eng4313/Power-Box/Document/نمایشگر در حالت پیشفرض تعدادی عکس روی نمایشگر نمایش میدهد که هر چند ثانیه عکس ها جابه جا میشود.docx

نمایشگر در حالت پیشفرض تعدادی عکس روی نمایشگر نمایش میدهد که هر چند ثانیه عکس ها جابه جا میشود. همچنین ساعت و تاریخ شمسی نیز در بالای نمایشگر نمایش داده شود.

پایین نمایشگر یک گزینه برای برداشتن و یک گزینه برای گزاشتن گوشی و یک گزینه ورود ادمین نمایش داده میشود که کاربر یکی را میتواند انتخاب کند که پس از انتخاب هر کدام سیستم وارد فرایند مربوط به همان گزینه میشود

فرایند گزاشتن گوشی

اگر کمد خالی وجود نداشته باشد پیغام مربوطه نمایش داده میشود.

اول دو گزینه نمایش داده میشود که نوع گوشی که اندروید یا آیفون است باید توسط کاربر انتخاب شود.

پس از آن یک صفحه کلید روی نمایشگر ظاهر میشود که توسط آن کاربر شماره موبایلی که باید 11 رقمی باشد را وارد میکند و تا زمانی که شماره صحیح نباشد سیستم در همین صفحه میماند و اگر شماره صحیح بود یک پیغام تاییدیه به کاربر نمایش داده میشود که شماره فلان مورد تایید هست یا خیر. اگر خیر انتخاب شد که مجدد به صفحه شماره تلفن برمیگردد جهت ویرایش و اگر کاربر تایید کرد پیغام اثر انگشت خود را وارد نمایید به کاربر نمایش داده میشود. کاربر 60 ثانیه وقت دارد تا اثر انگشت صحیح و خوانا و مورد تایید را وارد نماید و اگر این زمان تمام شد سیستم به مرحله نمایش عکس های پیشفرض بر میگردد و اگر صحیح بود سیستم درخواست ورود اثر انگشت مجدد را به کاربر اعلام میکند جهت انطباق و تایید اثر انگشت و برای این مرحله هم 60 ثانیه وقت به کاربر داده میشود و اگر وقت تمام شد مجدد به مرحله نمایش تصاویر پیشفرض بر میگردد. اگر اثر انگشت ها با هم منطبق نبود پیغام عدم انطباق نمایش داده میشود و اگر منطبق بود در یکی از کمد هایی که خالی است باز میشود و به کاربر 150 ثانیه وقت داده میشود تا گوشی را داخل کمد قرار دهد و درب را ببند و اگر این زمان تمام شد پیغام خطا نمایش داده میشود و ال ای دی داخل کمد چشمک زن میشود و در غیر این صورت چراغ بصورت ثابت روشن میماند.

شماره تلفن وارد شده و اثر انگشت وارد شده در حافظه EEPROM ذخیره میشود و در هر مرحله جهت سهولت کاربر یک پیغام صوتی برای کاربر پخش میشود.

فرایند برداشتن گوشی

بعد از انتخاب گزینه برداشتن گوشی وارد بخش صفحه کلید میشود تا کاربر شماره موبایل را وارد نماید. اگر شماره وارد شده با شماره های ذخیره شده منطبق نبود پیغام مربوطه نمایش داده میشود و به کاربر نهایتا 3 بار فرصت وارد کردن شماره موبایل صحیح داده میشود و اگر این دفعات تمام شد به صفحه نمایش تصاویر پیشفرض بر میگردد و اگر شماره منطبق بود پیغام ورود اثر انگشت نمایش داده میشود و اگر شماره و اثر انگشت با هم منطبق نباشند مثل حالت قبل سه بار به کاربر فرصت داده میشود و در صورت تمام شدن این دفعات پیغام قفل موقت کمد به مدت 30 دقیقه به کاربر نمایش داده میشود و به صفحه اول برمیگردد. اگر انطباق داشت هم درب مربوطه باز میشود و به کاربر 60 ثانیه وقت داده میشود تا گوشی را برداشته و درب را ببندد. اگر درب بسته شد که شماره و اثر انگشت مربوطه از حافظه کمد ها پاک میشود و ال ای دی خاموش میشود و در غیر اینصورت ال ای دی چشمک زن شده و هر 30 ثانیه پیغام درب کمد فلان باز است نمایش داده میشود.

جهت سهولت همه مراحل شامل پیغام صوتی است

ثبت لاگ سیستم

اتفاقاتی حیاتی سیستم باید در حافظه EEPROM ثبت شود که این اتفاقات شامل موارد زیر میباشد.

شماره تلفن کاربر، شماره کمدی که گوشی کاربر درون آن قرار گرفته و ساعت و تاریخ ورود و خروج گوشی. اگر کمد توسط رمز ادمین باز شد باید مشخص شود که توسط ادمین شماره فلان کمد باز شده است.

اگر خطای 30 دقیقه برای کمد رخ داد باید در لاگ ها ثبت شود.

اگر کاربر پس از قرار دادن گوشی درب کمد را نبست باید لاگ ثبت شود.

اگر کاربر پس از برداشتن گوشی درب را نبست لاگ ثبت شود

تعداد لاگ های موجود در سیستم 100 برابر تعداد کمد ها میباشد یعنی اگر تعداد کمد ها 8 تا بود سیستم باید بتواند 800 لاگ آخر را ذخیره نماید و به ادمین ها نشان دهد.

این لاگ ها بصورت صفحه به صفحه و از آخر به اول و در قالب یک جدول باید نمایش داده شود که در هر صفحه 50 لاگ نمایش داده میشود و یه گزینه برای رفتن به صفحه بعد و یک گزینه برای برگشتن به صفحه قبل در این صفحات باید وجود داشته باشد. و این عدد 50 هم باید بصورت دیفاین شده تعریف شود.

ورود ادمین

پس از انتخاب این گزینه وارد بخش صفحه کلید میشود که پس از ورود رمز ادمین وارد منوی مربوط به ادمین میشود و در غیر این صورت پیغام رمز اشتباه است به ادمین نمایش داده میشود. اگر رمز ادمین درست باشد وارد صفحه ای میشود که ادمین با انتخاب شماره هر کمد میتواند درب آن کمد را باز نماید. همچنین ادمین باید بتواند رمز مربوط به خود را تغییر دهد و لاگ های اخر سیستم را مشاهده نماید.

سیستم 20 ادمین مختلف میتواند داشته باشد که یکی از این ها ادمین اصلی است و رمز پیشفرض آن 000000 میباشد و ادمین اصلی همان دسترسی های سایر ادمین ها را دارد و همچنین باید بتواند ادمین را اضافه یا حذف نماید.

همچنین ادمین میتواند 100 لاگ آخر سیستم را مشاهده کند.

نکته مهم اینه که فعلا بورد من میتونه 8 تا کمد مدیریت کنه ولی ممکنه که بخوام با همین بورد یه دستگاه 4 کانال یا 8 کانال مدیریت کنم و طبیعتا باید تعداد این کمد ها دیفاین بشه. همچنین تعداد ادمین ها و رمز پیشفرض و همه این مقادیر باید دیفاین بشن.

یکی از کلید هایی که روی بورد هست هم وظیفه ریست کردن رمز ادمین اصلی به 000000 را دارد که اگر 10 ثانیه فشرده شود این رمز ریست میشود.
