eng4313/Power-Box/PCB/Power_Box_V2/Project Outputs for Power_Box_V2/Power_Box_V2.xlsx

Comment | Description | Designator | Footprint | LibRef | Quantity
Bat Holder 2016-SMD | BATTERY | BAT1 | BAT-HOLDER-SMD-1220 | BATTERY HOLDER | 1
CAP Cer 100nF-50V-X7R-SMD | CAPACITOR | C1A, C1B, C2A, C2B, C2C, C2D, C2E, C2F, C2G, C2H, C3, C5, C6, C8, C9, C10, C11, C13, C14, C15, C18, C19, C20, C21, C22, C23, C24, C25, C26, C27, C28, C29, C30, C31, C34, C36, C39, C41, C45, C46, C50, C51, C52, C53, C54, C55, C56, C57, C59, C61 | C-0805 | CAP-CER | 50
CAP Cer 4.7uF-50V-X7R-SMD | CAPACITOR | C4, C7 | C-0805 | CAP-CER | 2
CAP Cer 10uF-50V-X7R-SMD | CAPACITOR | C12, C35, C38, C58, C60 | C-0805 | CAP-CER | 5
CAP Cer 18pF-50V-X7R-SMD | CAPACITOR | C16, C17 | C-0805 | CAP-CER | 2
CAP Tantal 2.2uF-10V-A-SMD | CAPACITOR | C32, C37 | TAN-A | CAP-TAN | 2
CAP Cer 22uF-50V-X7R-SMD | CAPACITOR | C33 | C-0805 | CAP-CER | 1
CAP Cer 10nF-1KV-X7R-THD | CAPACITOR | C40 | CAP-CER-7x2.5-Ls5 | CAP-CER | 1
CAP Cer 1uF-50V-X7R-SMD | CAPACITOR | C42 | C-0805 | CAP-CER | 1
CAP Elec 1000uF-25V-10x25-THD | CAPACITOR | C43 | CAP-Elec-10x25-5 | CAP-ELEC | 1
CAP Elec 1000uF-10V-5x7mm-THD | CAPACITOR | C44 | cap-Elec-5x7 | CAP-ELEC | 1
CAP Cer 4.7uF-16V-X7R-SMD | CAPACITOR | C47 | C-0805 | CAP-CER | 1
CAP Cer 2.2uF-25V-X7R-SMD | CAPACITOR | C48, C49 | C-0805 | CAP-CER | 2
Connector XH-Straight-THD-2.54mm | CONNECTOR | CN1A, CN1B, CN1C, CN1D, CN1E, CN1F, CN1G, CN1H | XH-5 | CN-5pin | 8
Connector XH-2-Straight-THD-2.54mm | CONNECTOR | CN2 | XH-2 | CN-2pin | 1
Connector FPC Right-0.5mm-50 Pin | CONNECTOR | CN3 | CN-FPC-50-0.5mm-hor | CN-FPC-50pin | 1
Connector XH-Straight-THD-2.54mm | CONNECTOR | CN4 | XH-6 | CN-6pin | 1
Connector FPC Right-1mm-4 Pin | CONNECTOR | CN5 | CN-FPC-4-1mm-hor | CN-FPC-4pin | 1
Diode 1N4148-SMD | DIODE | D1A, D1B, D1C, D1D, D1E, D1F, D1G, D1H, D2 | SOD80 | DIODE | 9
Diode 1N5408-SMD | DIODE | D3 | D-DO214 | DIODE | 1
Diode Schottky SS34-SMD | DIODE | D4 | D-DO214AB | DIODE-SCHOTTKY | 1
Ferrite Bead SMD | INDUCATOR | FB1, FB2, FB3, FB5, FB6, FB7, FB8, FB9 | FB-0805 | FERRITE BEAD | 8
FERRITE BEAD | INDUCATOR | FB4 | FB-0805 | FERRITE BEAD | 1
Header 4x1 Pin -Straight-Male-2.54mm | HEADER | H1 | H-4pin-M-S | HEADER-4pin | 1
Header 3x1 Pin -Straight-Male-2.54mm | HEADER | H2, H3 | H-3pin-M-S | HEADER-3pin | 2
IND 10uH-10x10mm-SMD | INDUCATOR | L1 | IND-SMD-1010 | INDUCATOR | 1
LED GREEN-1206-SMD | LED | LED1, LED3, LED4 | LED-1206-Y | LED | 3
LED RED-1206-SMD | LED | LED2 | LED-1206-R | LED | 1
Mic 2.2mm-THD | MIC | MIC1 | MIC-2.2mm | MIC | 1
TR 2N2222-SMD | TRANSISTOR | Q1A, Q1B, Q1C, Q1D, Q1E, Q1F, Q1G, Q1H | SOT23-213 | 2N2222 | 8
TR S8050-SMD | TRANSISTOR | Q2A, Q2B, Q2C, Q2D, Q2E, Q2F, Q2G, Q2H | SOT23-213 | S8050 | 8
RES 10K-5%-1/8W-SMD | RESISTOR | R1A, R1B, R15, R44, R46, R47, R48, R57, R58, R60, R61 | R-0805 | RES | 11
RES 680R-5%-1/8W-SMD | RESISTOR | R2A, R2B, R2C, R2D, R2E, R2F, R2G, R2H | R-0805 | RES | 8
RES 47K-5%-1/8W-SMD | RESISTOR | R3A, R3B, R3C, R3D, R3E, R3F, R3G, R3H, R6A, R6B, R6C, R6D, R6E, R6F, R6G, R6H | R-0805 | RES | 16
RES 100R-5%-1/8W-SMD | RESISTOR | R4A, R4B, R4C, R4D, R4E, R4F, R4G, R4H | R-0805 | RES | 8
RES 1K-5%-1/8W-SMD | RESISTOR | R5A, R5B, R5C, R5D, R5E, R5F, R5G, R5H, R10, R50 | R-0805 | RES | 10
RES 470R-5%-1/8W-SMD | RESISTOR | R7A, R7B, R7C, R7D, R7E, R7F, R7G, R7H | R-0805 | RES | 8
RES 4.7K-5%-1/8W-SMD | RESISTOR | R8, R9, R11, R12, R14, R56 | R-0805 | RES | 6
RES 82K-5%-1/8W-SMD | RESISTOR | R13 | R-0805 | RES | 1
RES 10R-5%-1/8W-SMD | RESISTOR | R16, R17, R18, R43, R45 | R-0805 | RES | 5
RES 2.2K-5%-1/8W-SMD | RESISTOR | R49, R51, R52 | R-0805 | RES | 3
RES 100K-5%-1/8W-SMD | RESISTOR | R53 | R-0805 | RES | 1
RES 1.2R-5%-1/8W-SMD | RESISTOR | R54, R55 | R-1206 | RES | 2
RES 22R-5%-1/8W-SMD | RESISTOR | R59 | R-0805 | RES | 1
Push Button 3x6mm-2Pin-SMD | SWITCH | S1A, S1B, S2 | SW-SMD-2pin-3x6 | PUSH BUTTON | 3
Screw 3mm | SCREW | SC1, SC2, SC3, SC4 | Screw_M3 | SCREW | 4
Terminal KF301-2Pin-5.08mm-Straight | TERMINAL | TR1 | KF301-2pin | TEMINAL-2pin | 1
IC AT24C04-SMD | IC | U1 | SOIC8 | AT24C04 | 1
IC ISD1730-SMD | IC | U2 | SOIC28-wide | ISD1730 | 1
STM32F429ZGT6 | ARM Cortex-M4 32-bit MCU+FPU, 225 DMIPS, 1024 kB Flash, 256 kB Internal RAM, 114 I/Os, 144-pin LQFP, -40 to 85 degC, Tray | U3 | STM-LQFP144_N | STM32F429ZGT6 | 1
Reg LF33-3.3V-SMD | REGULATOR | U4 | TO252-3pin | LF33 | 1
Reg 7805-5V-THD | REGULATOR | U5 | TO220-HEARSINK-1 | 78Mxx | 1
IC MP3202-SMD | IC | U6 | SOT23-6N | MP3202 | 1
IC W25Qxx-SMD | IC | U7 | SOIC8-W | W25Qxx | 1
IC IS42S16400J-7TLI-SMD | IC | U8 | TSSOP-54 | IS42S16400J-7TLI | 1
IC XPT2046-SMD | IC | U9 | TSSOP-16 | XPT2046 | 1
Crystal 8MHz-SMD | CRYSTAL | Y1 | CRYSTAL-SMD | CRYSTAL | 1
Zener -3.3V-SMD | DIODE | ZD1A, ZD1B, ZD1C, ZD1D, ZD1E, ZD1F, ZD1G, ZD1H | SOD80 | DIODE-ZENER | 8
