eng4313/Power-Box/PCB/Power_Box_V2/Power_Box_V2.pdf

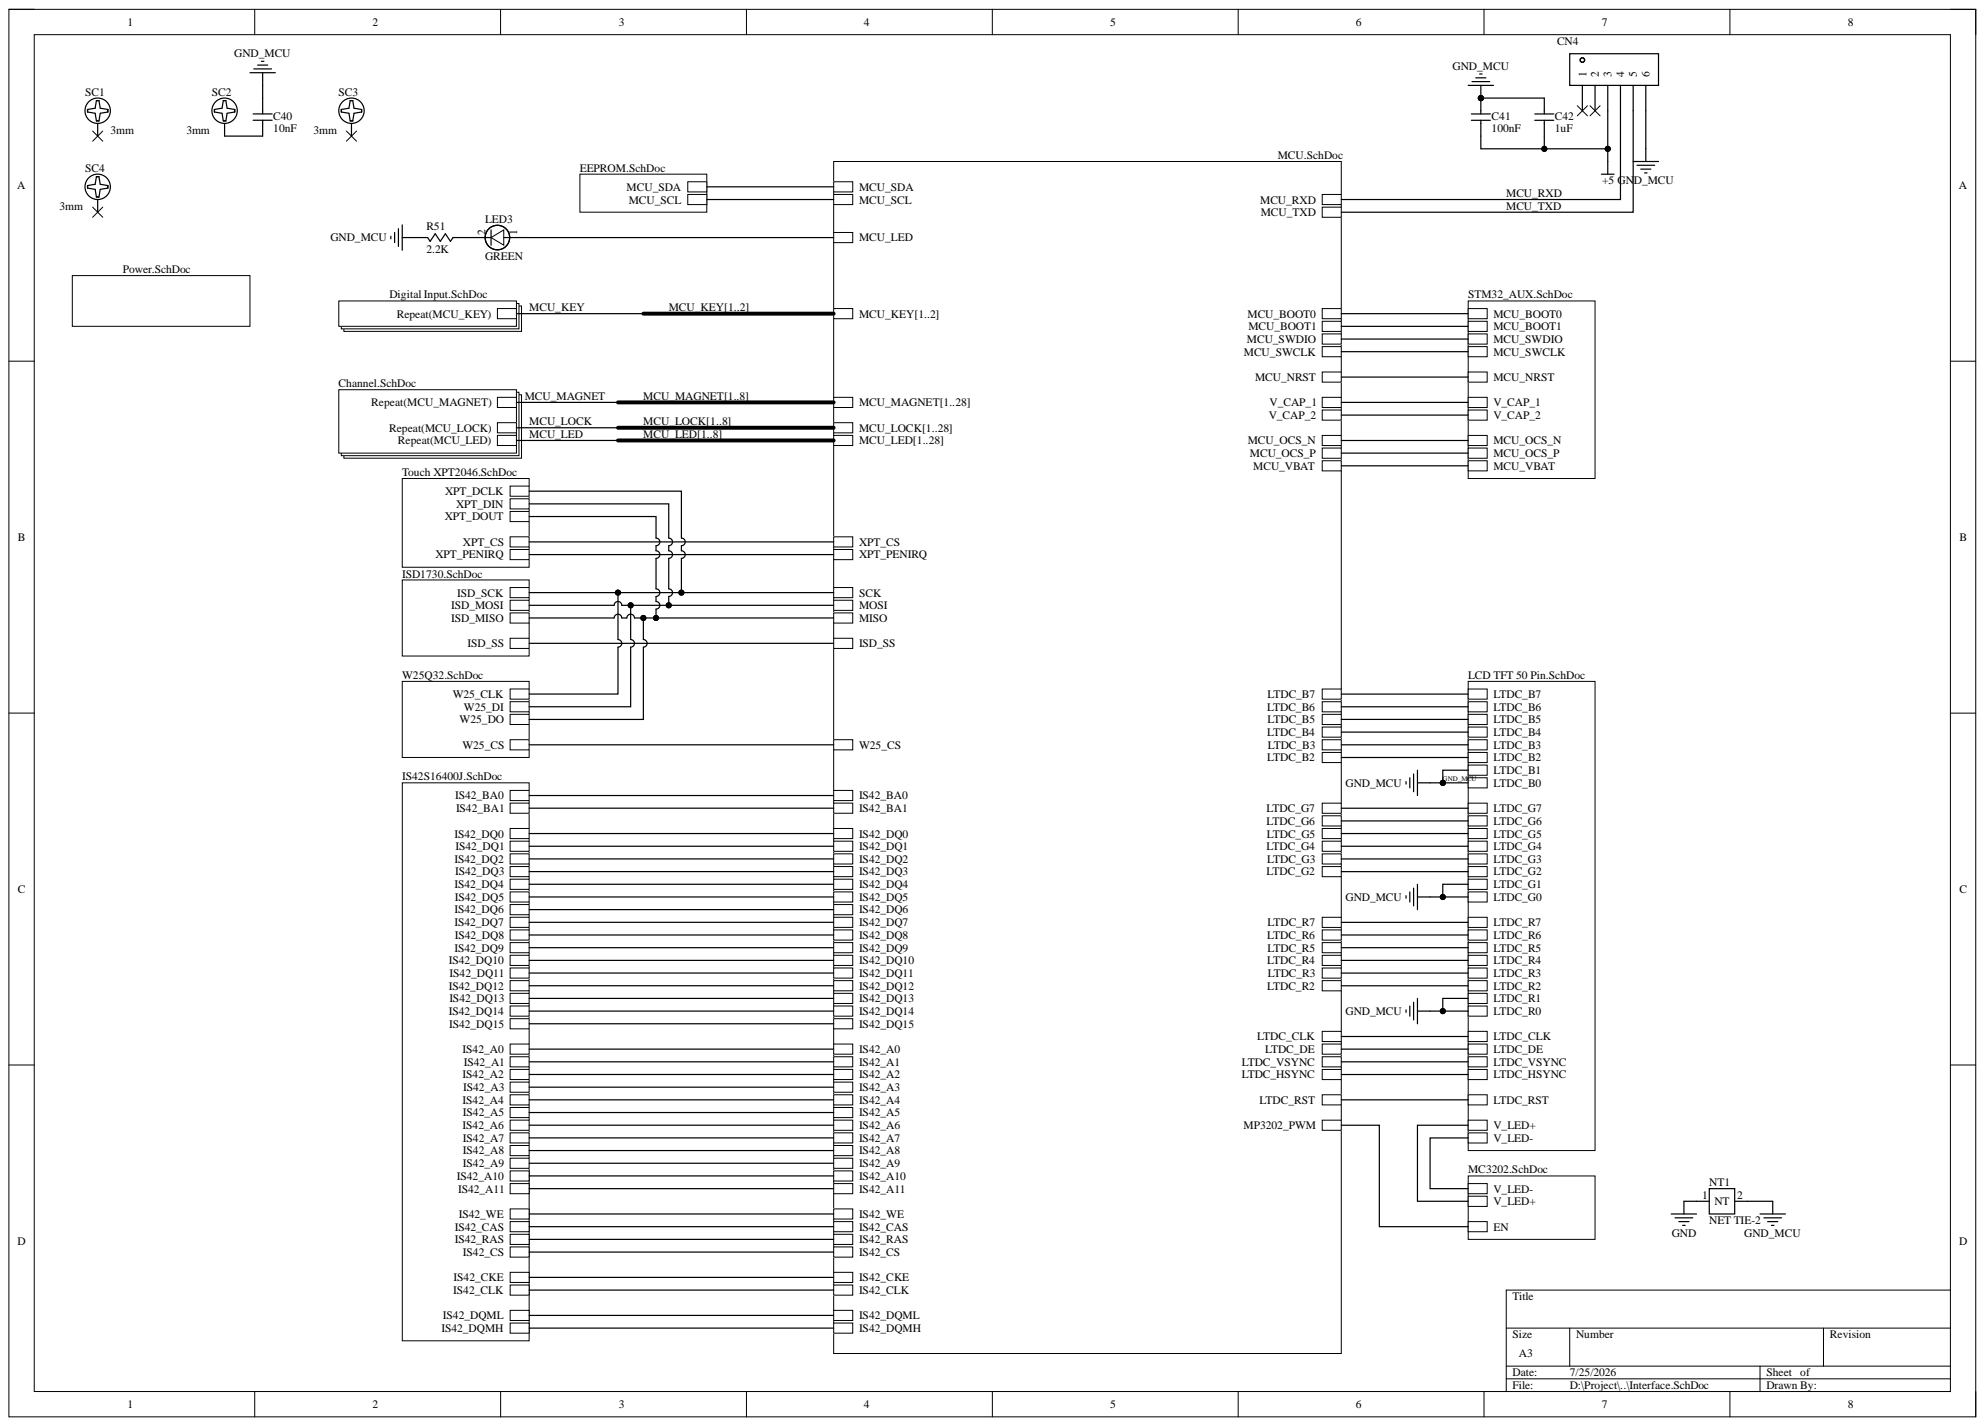
[picture p1: page 1]

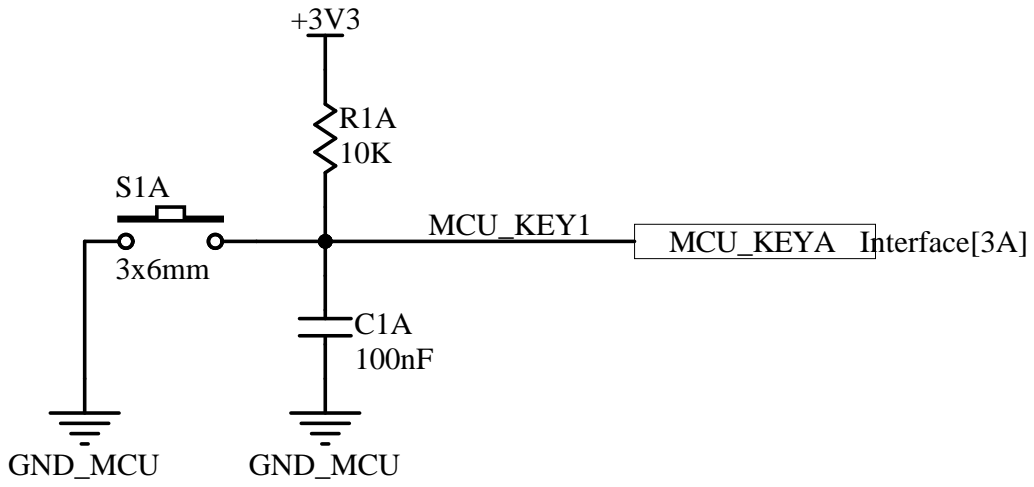
[picture p2: page 2]

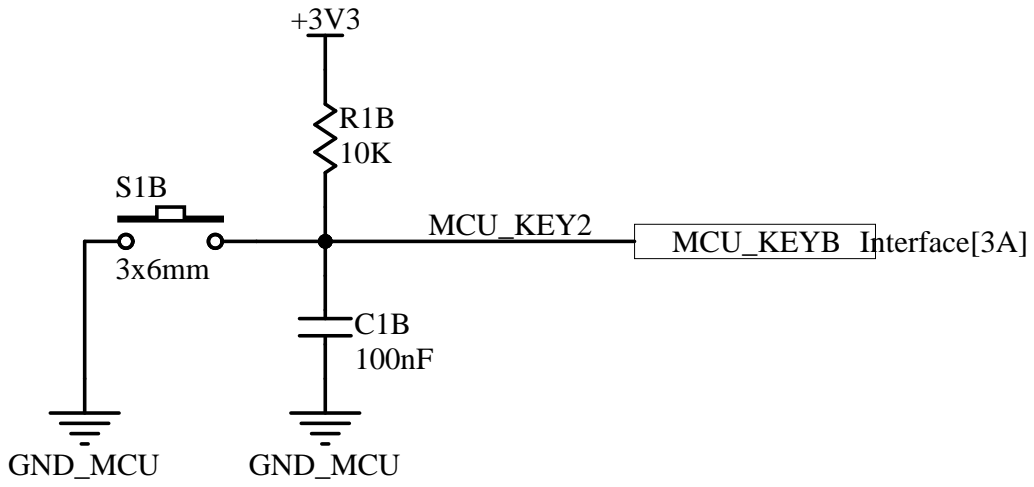
[picture p3: page 3]

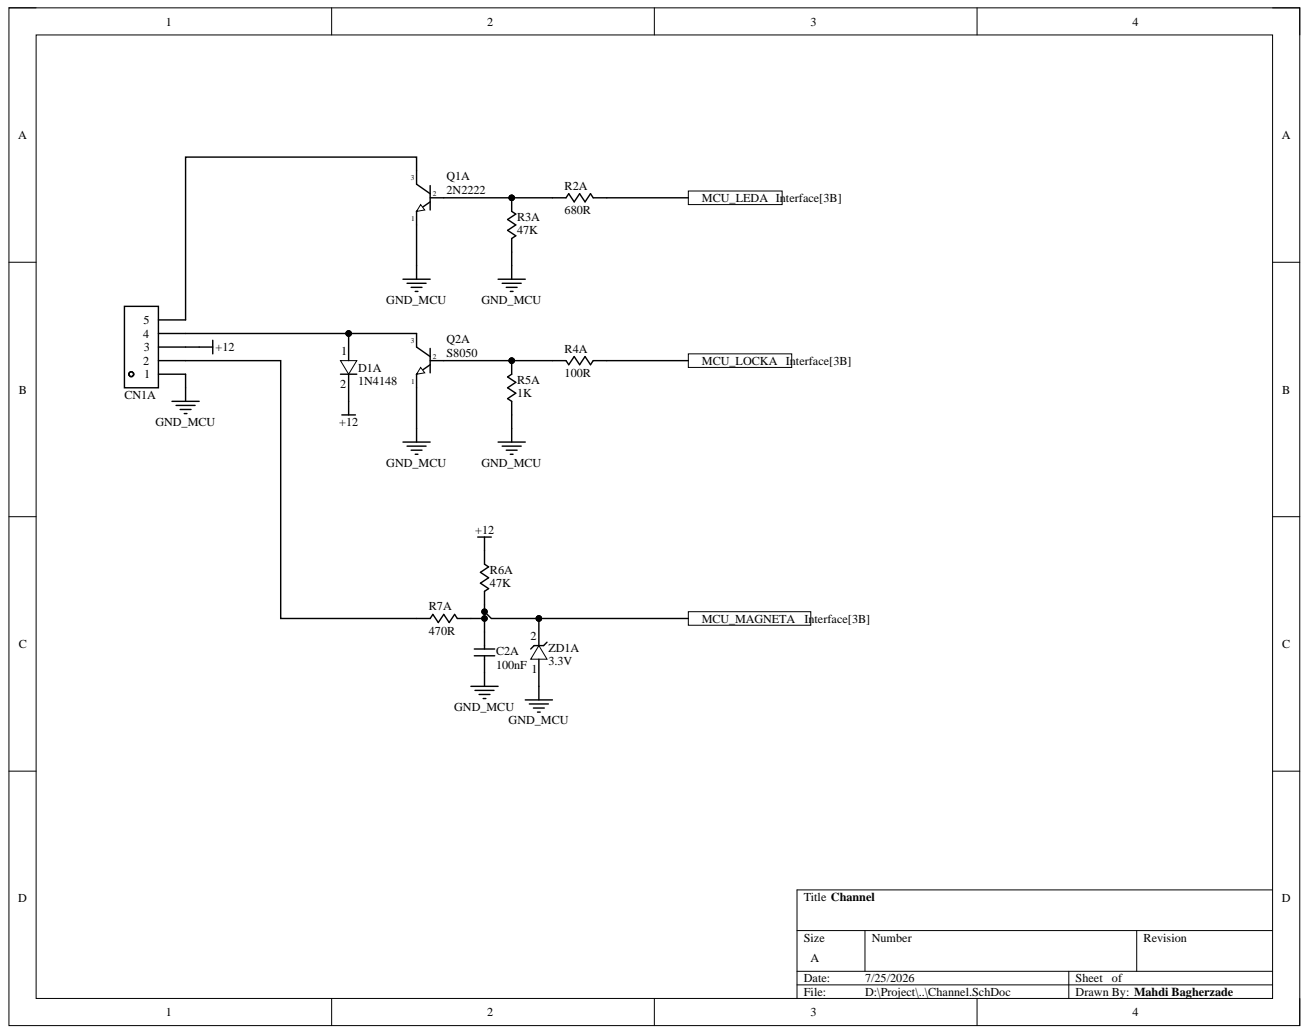
[picture p4: page 4]

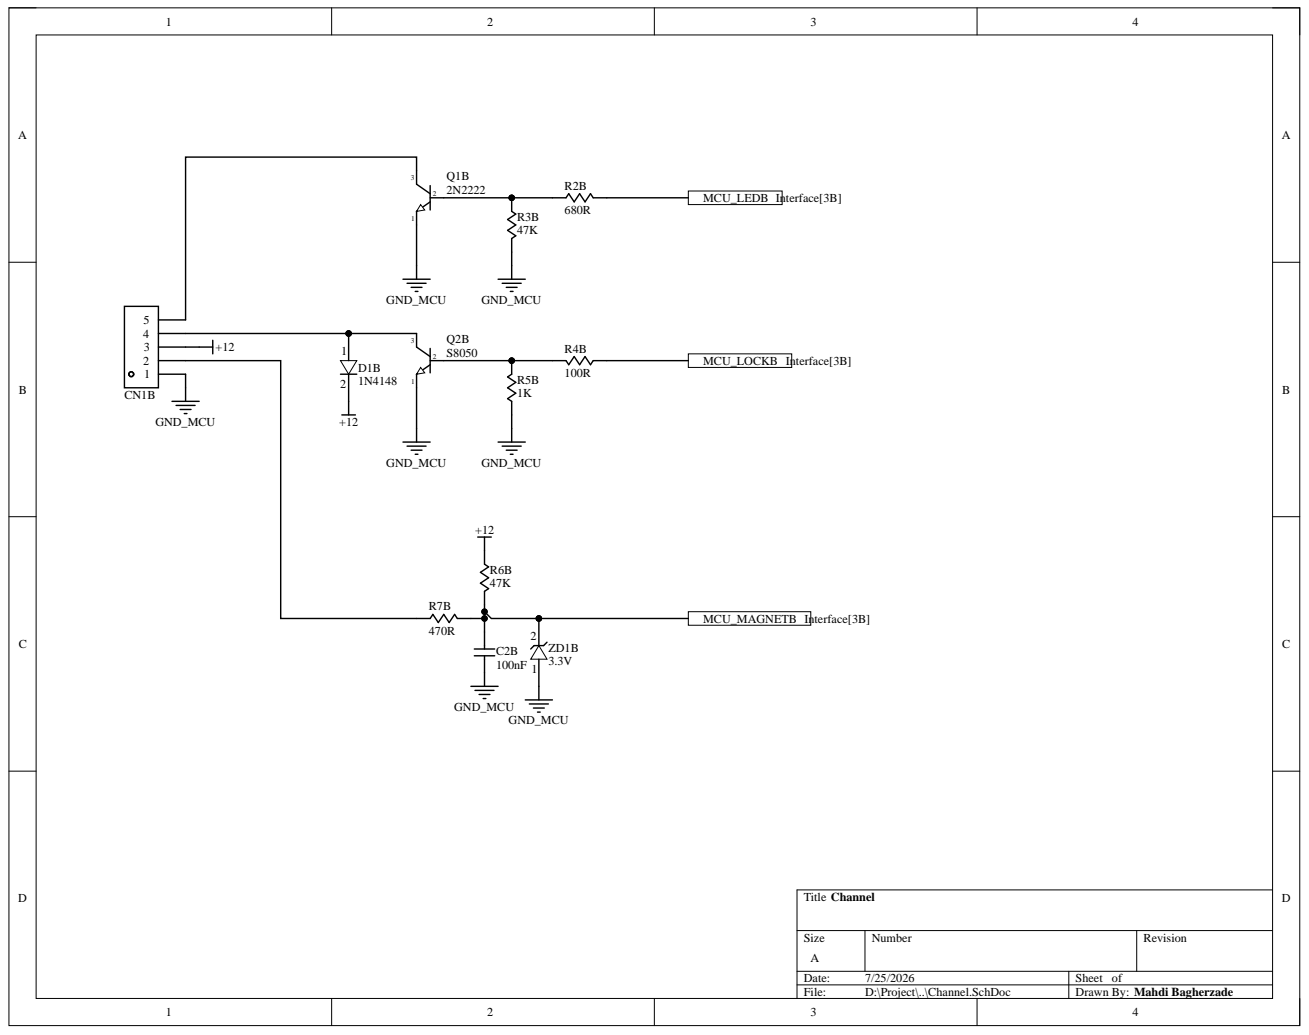
[picture p5: page 5]

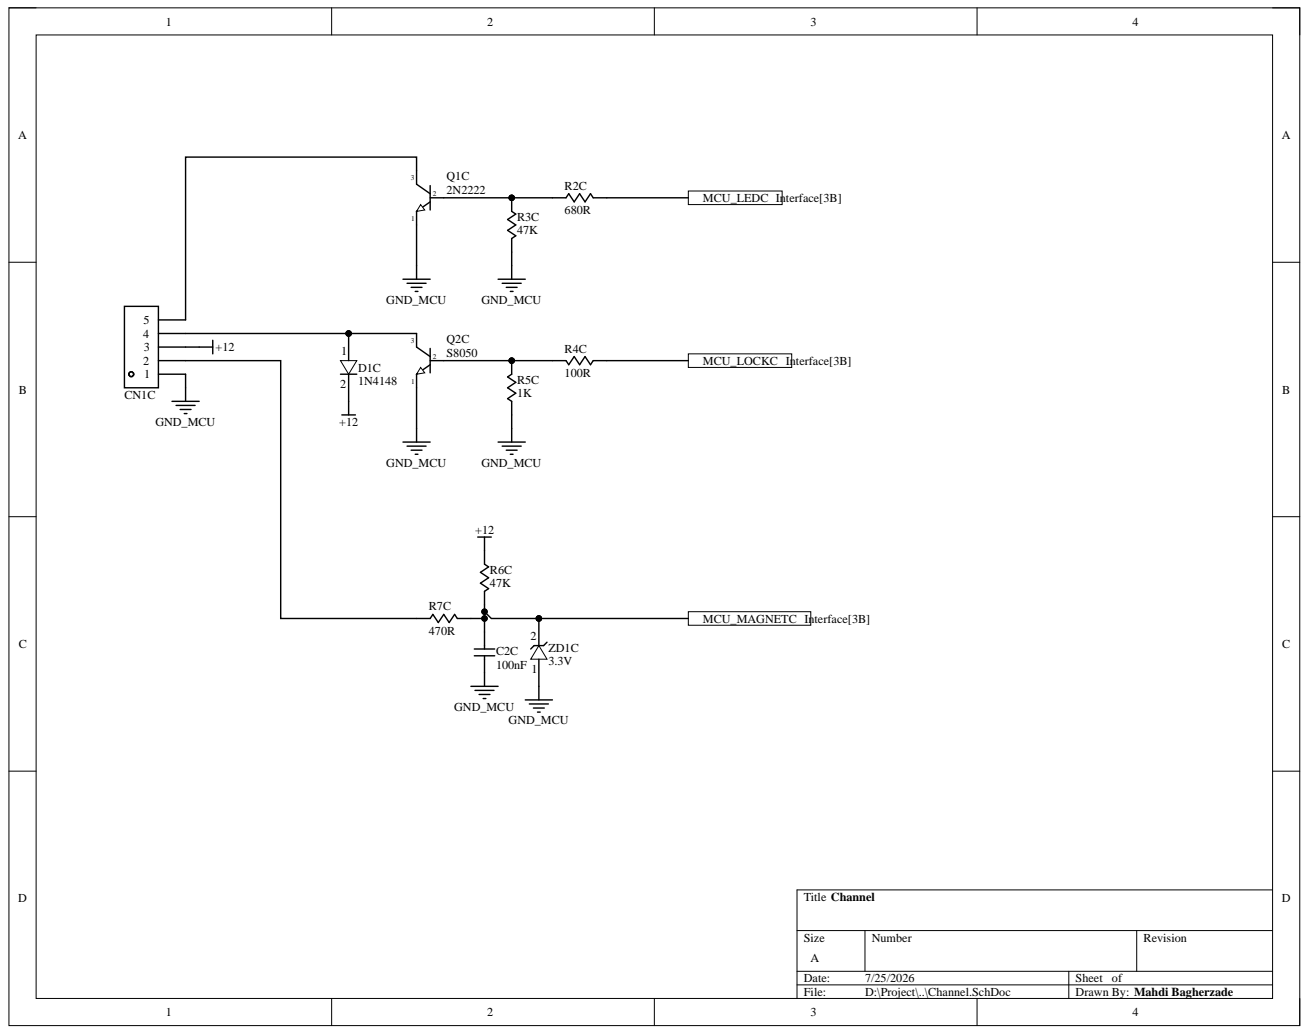
[picture p6: page 6]

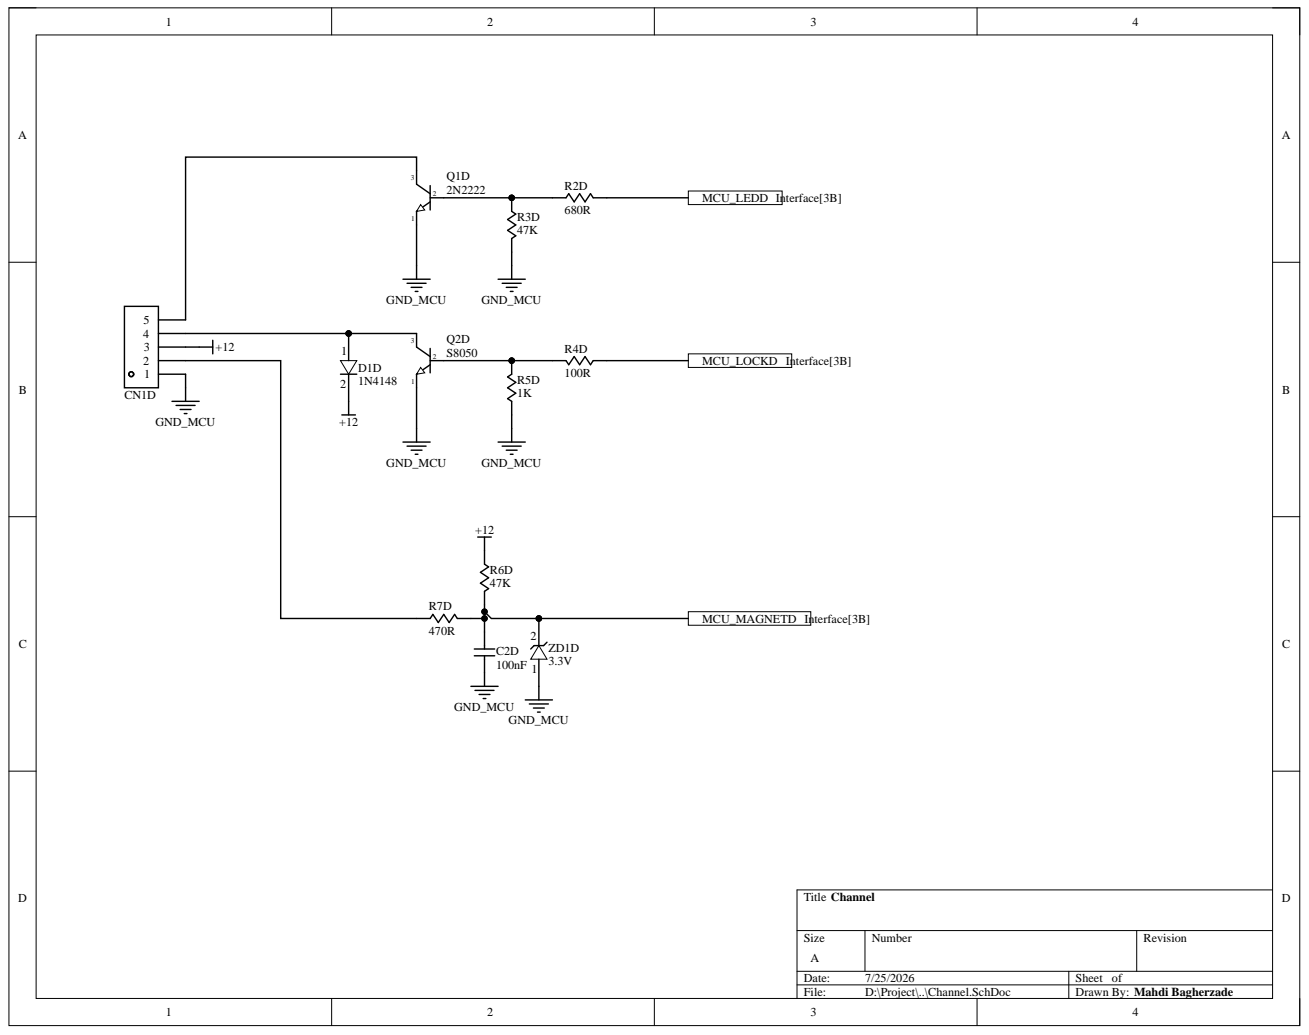
[picture p7: page 7]

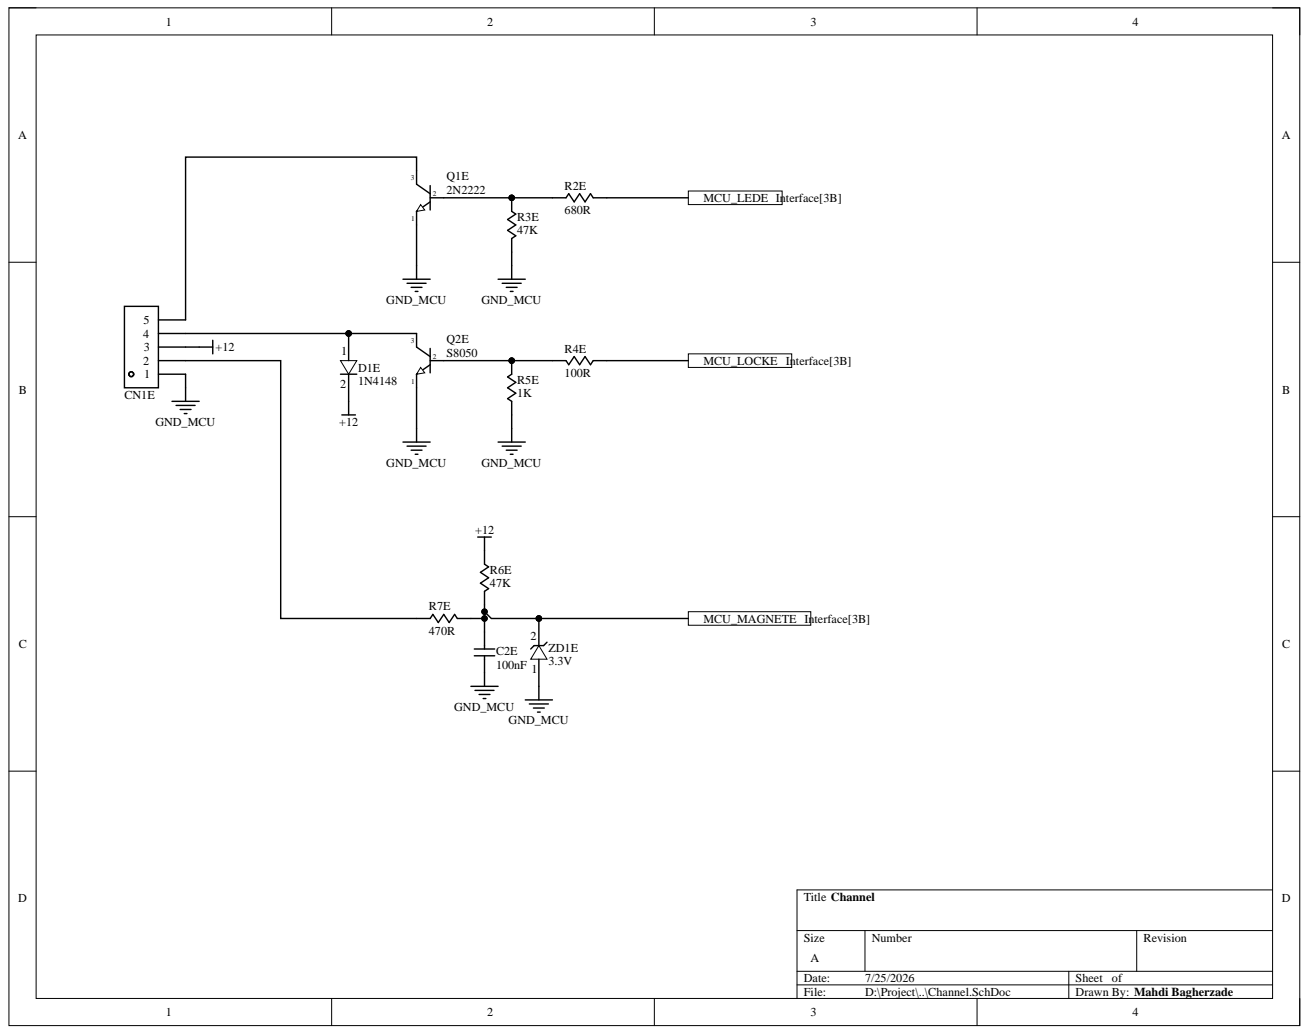
[picture p8: page 8]

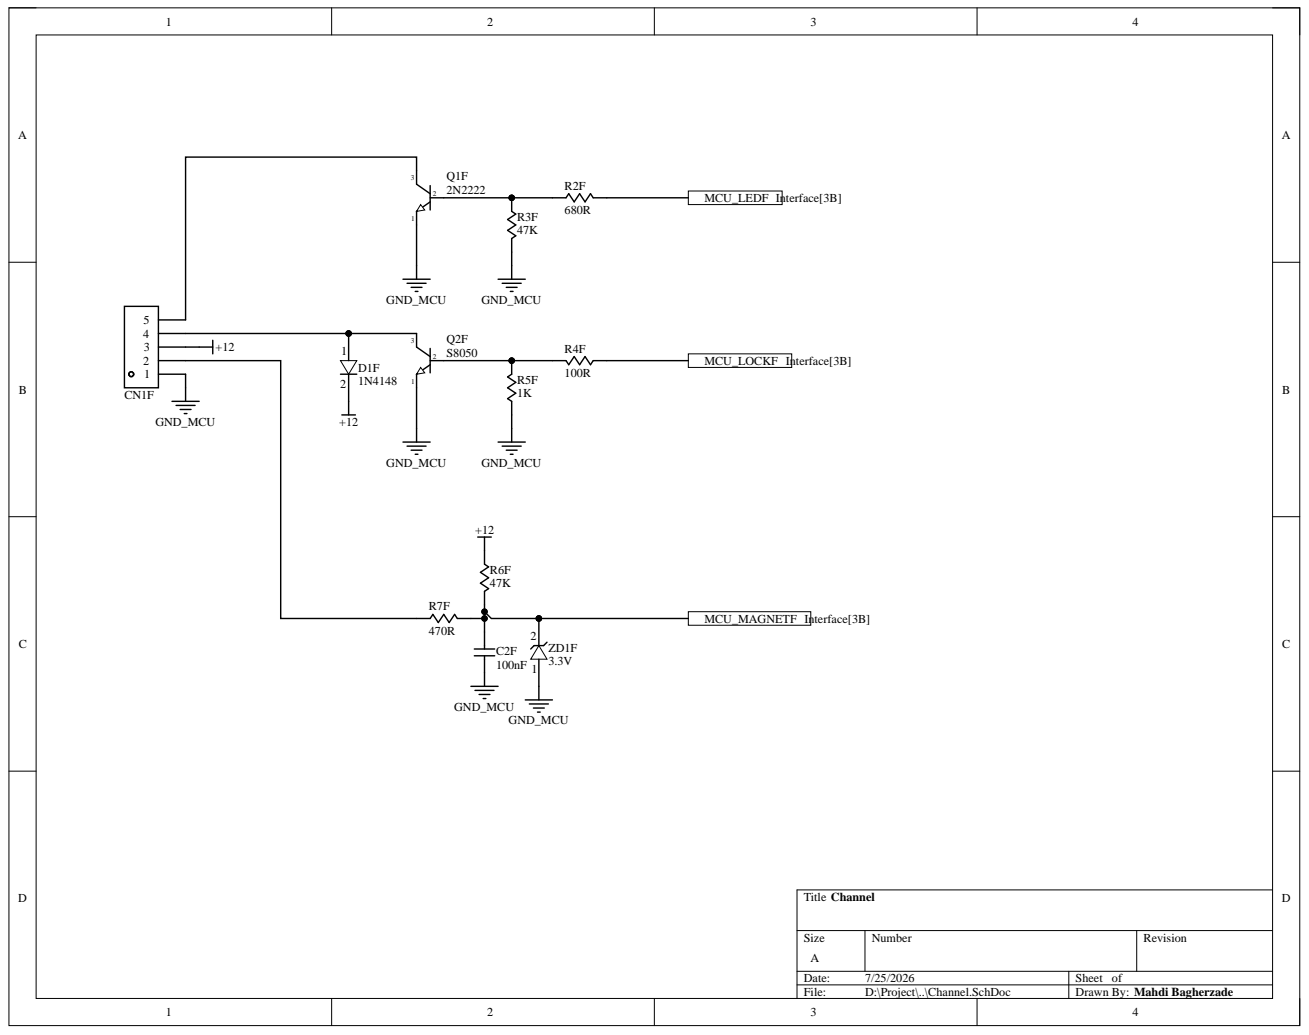
[picture p9: page 9]

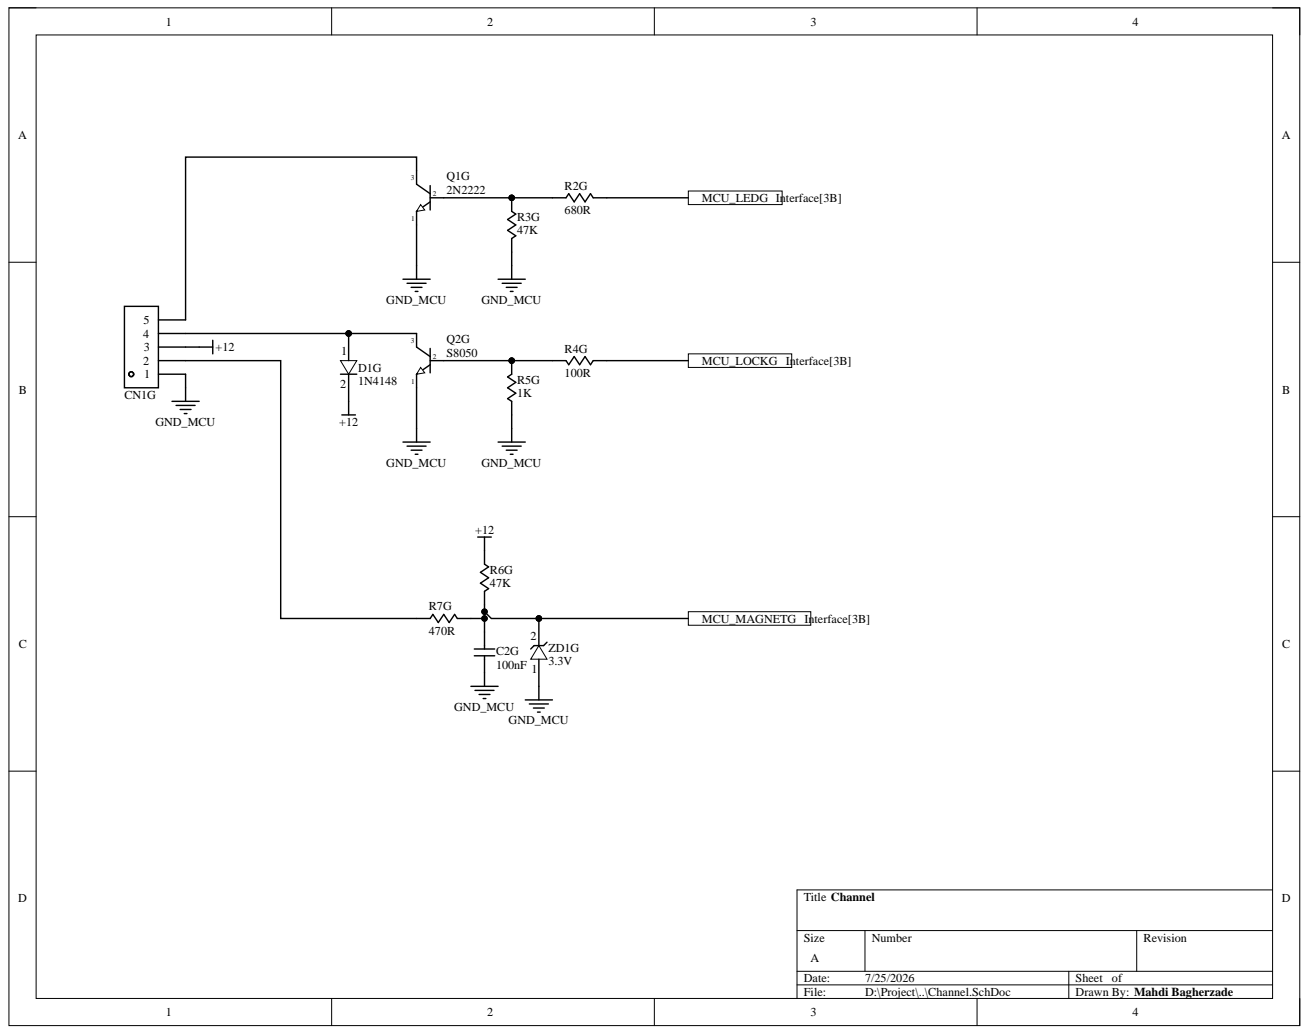
[picture p10: page 10]

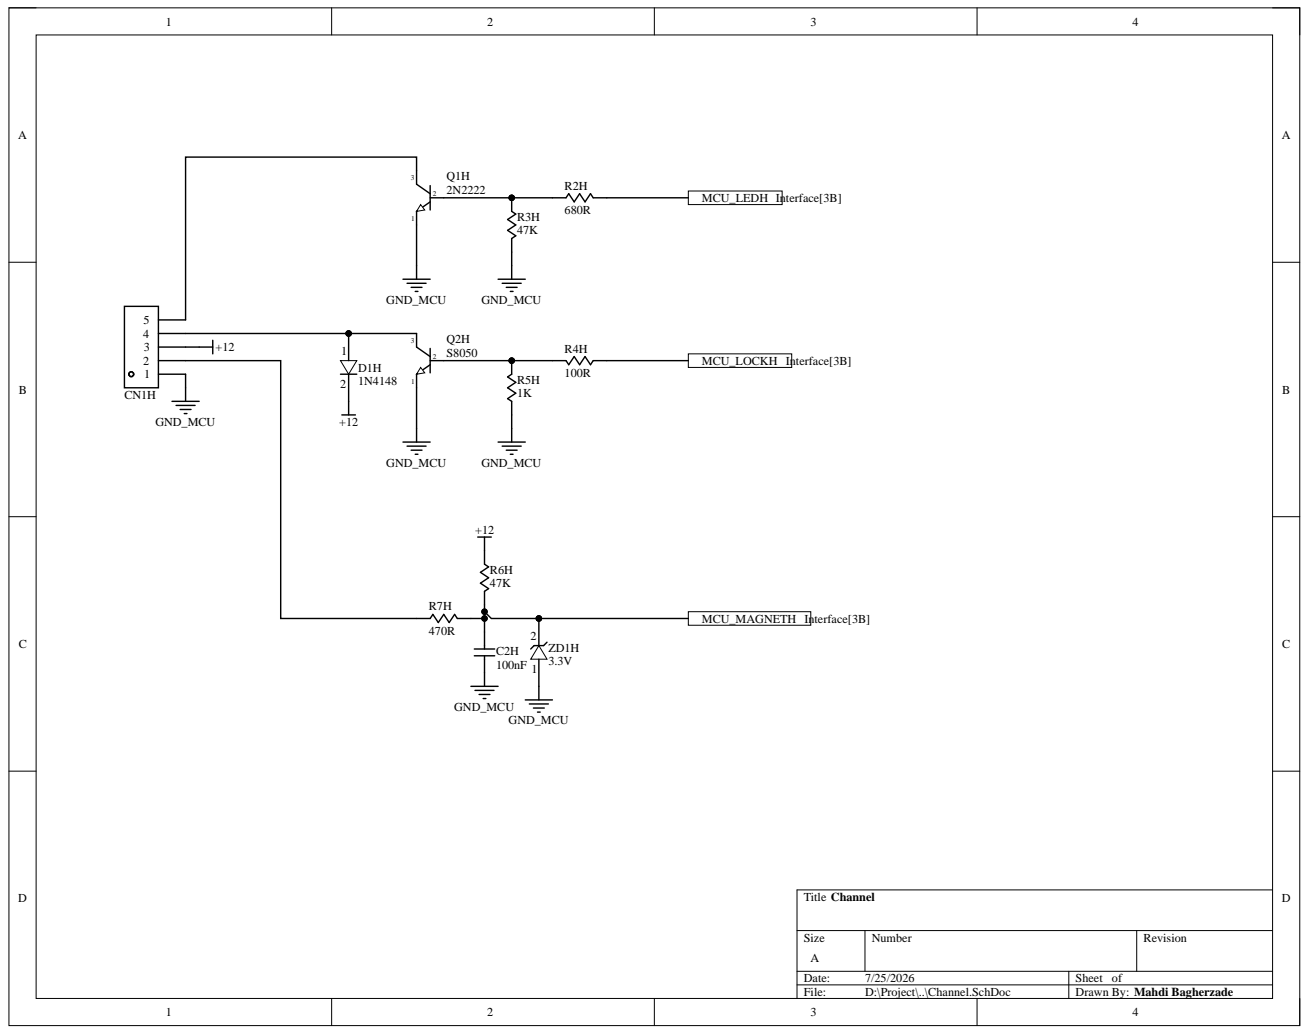
[picture p11: page 11]

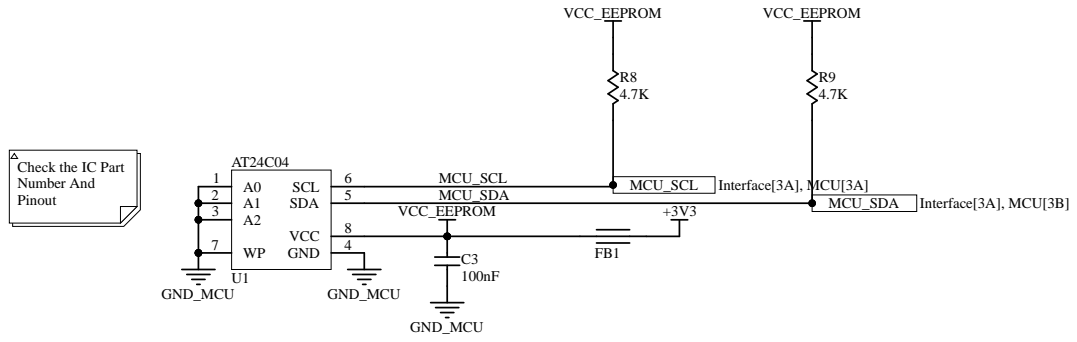
[picture p12: page 12]

Check the IC Part
Number And
Pinout

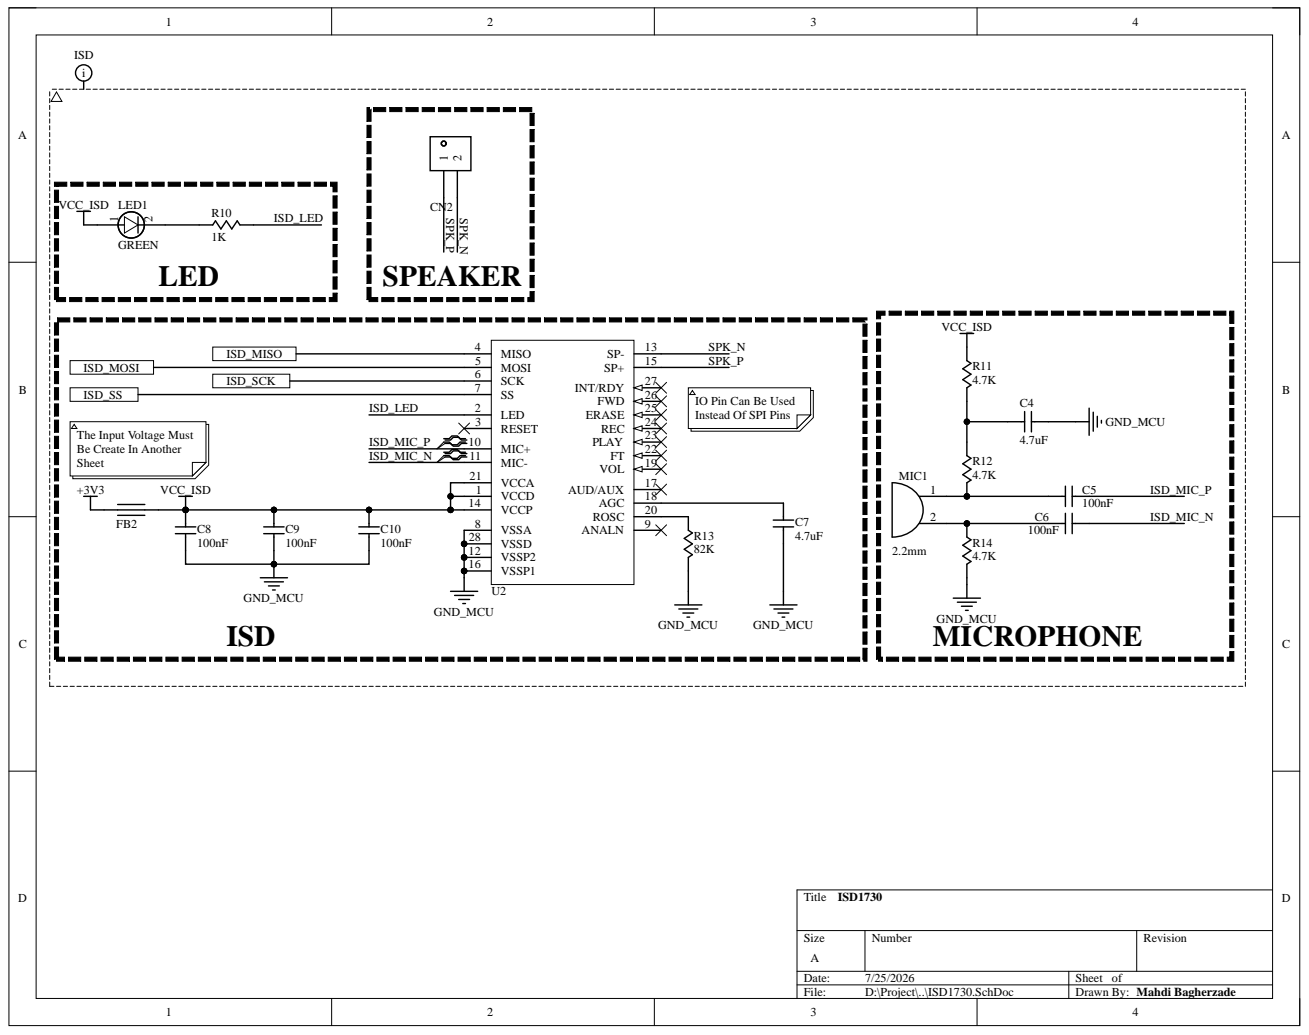
[picture p13: page 13]

IO Pin Can Be Used
Instead Of SPI Pins

The Input
Be Create In Another
Sheet

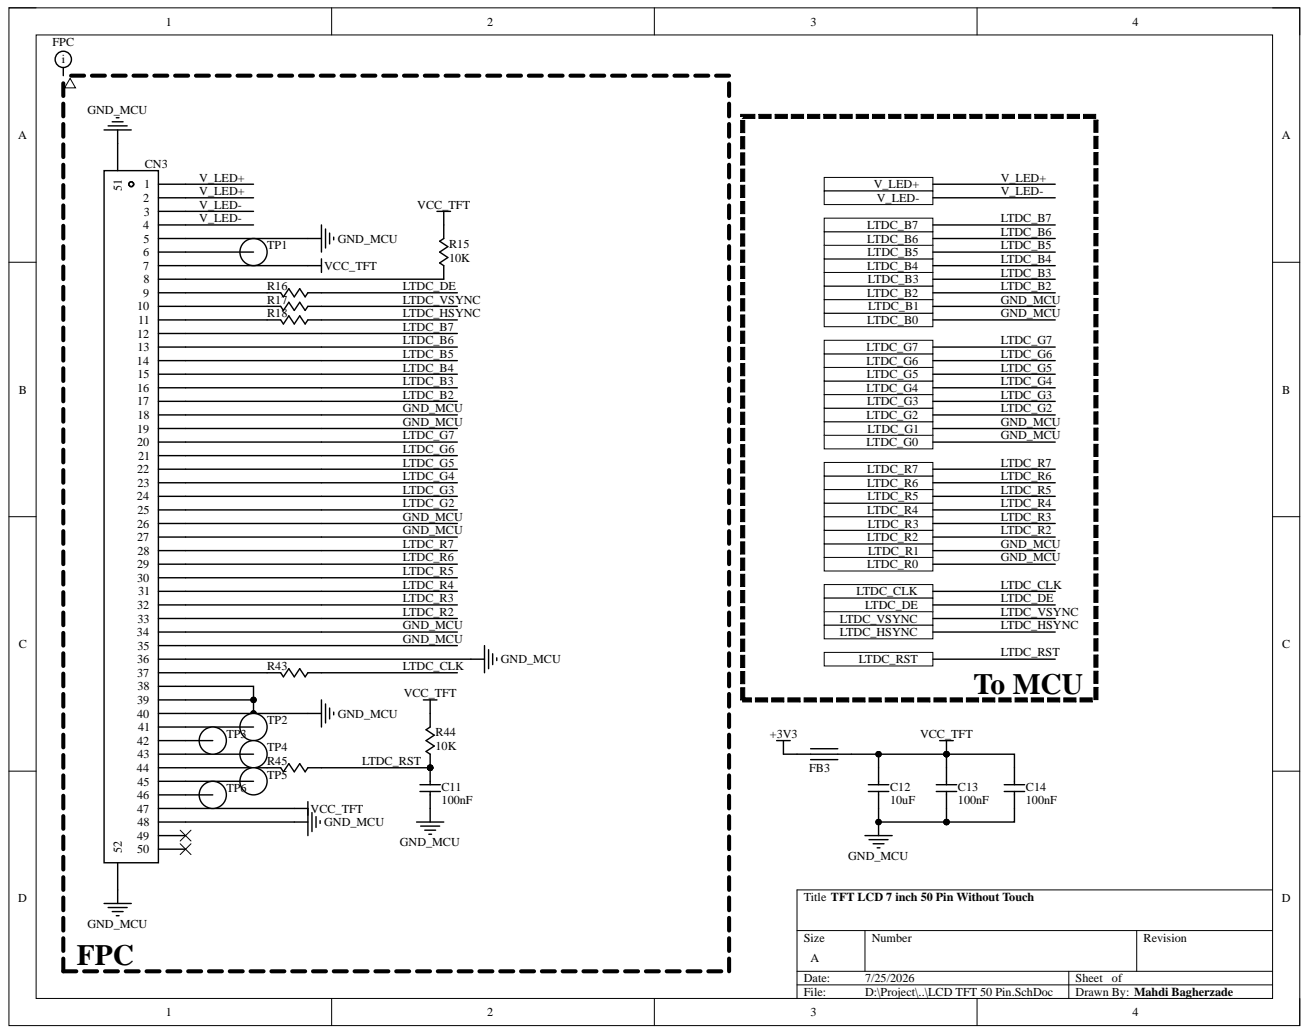
[picture p14: page 14]

Titl
TFT LCD 7 inch 50 Pin

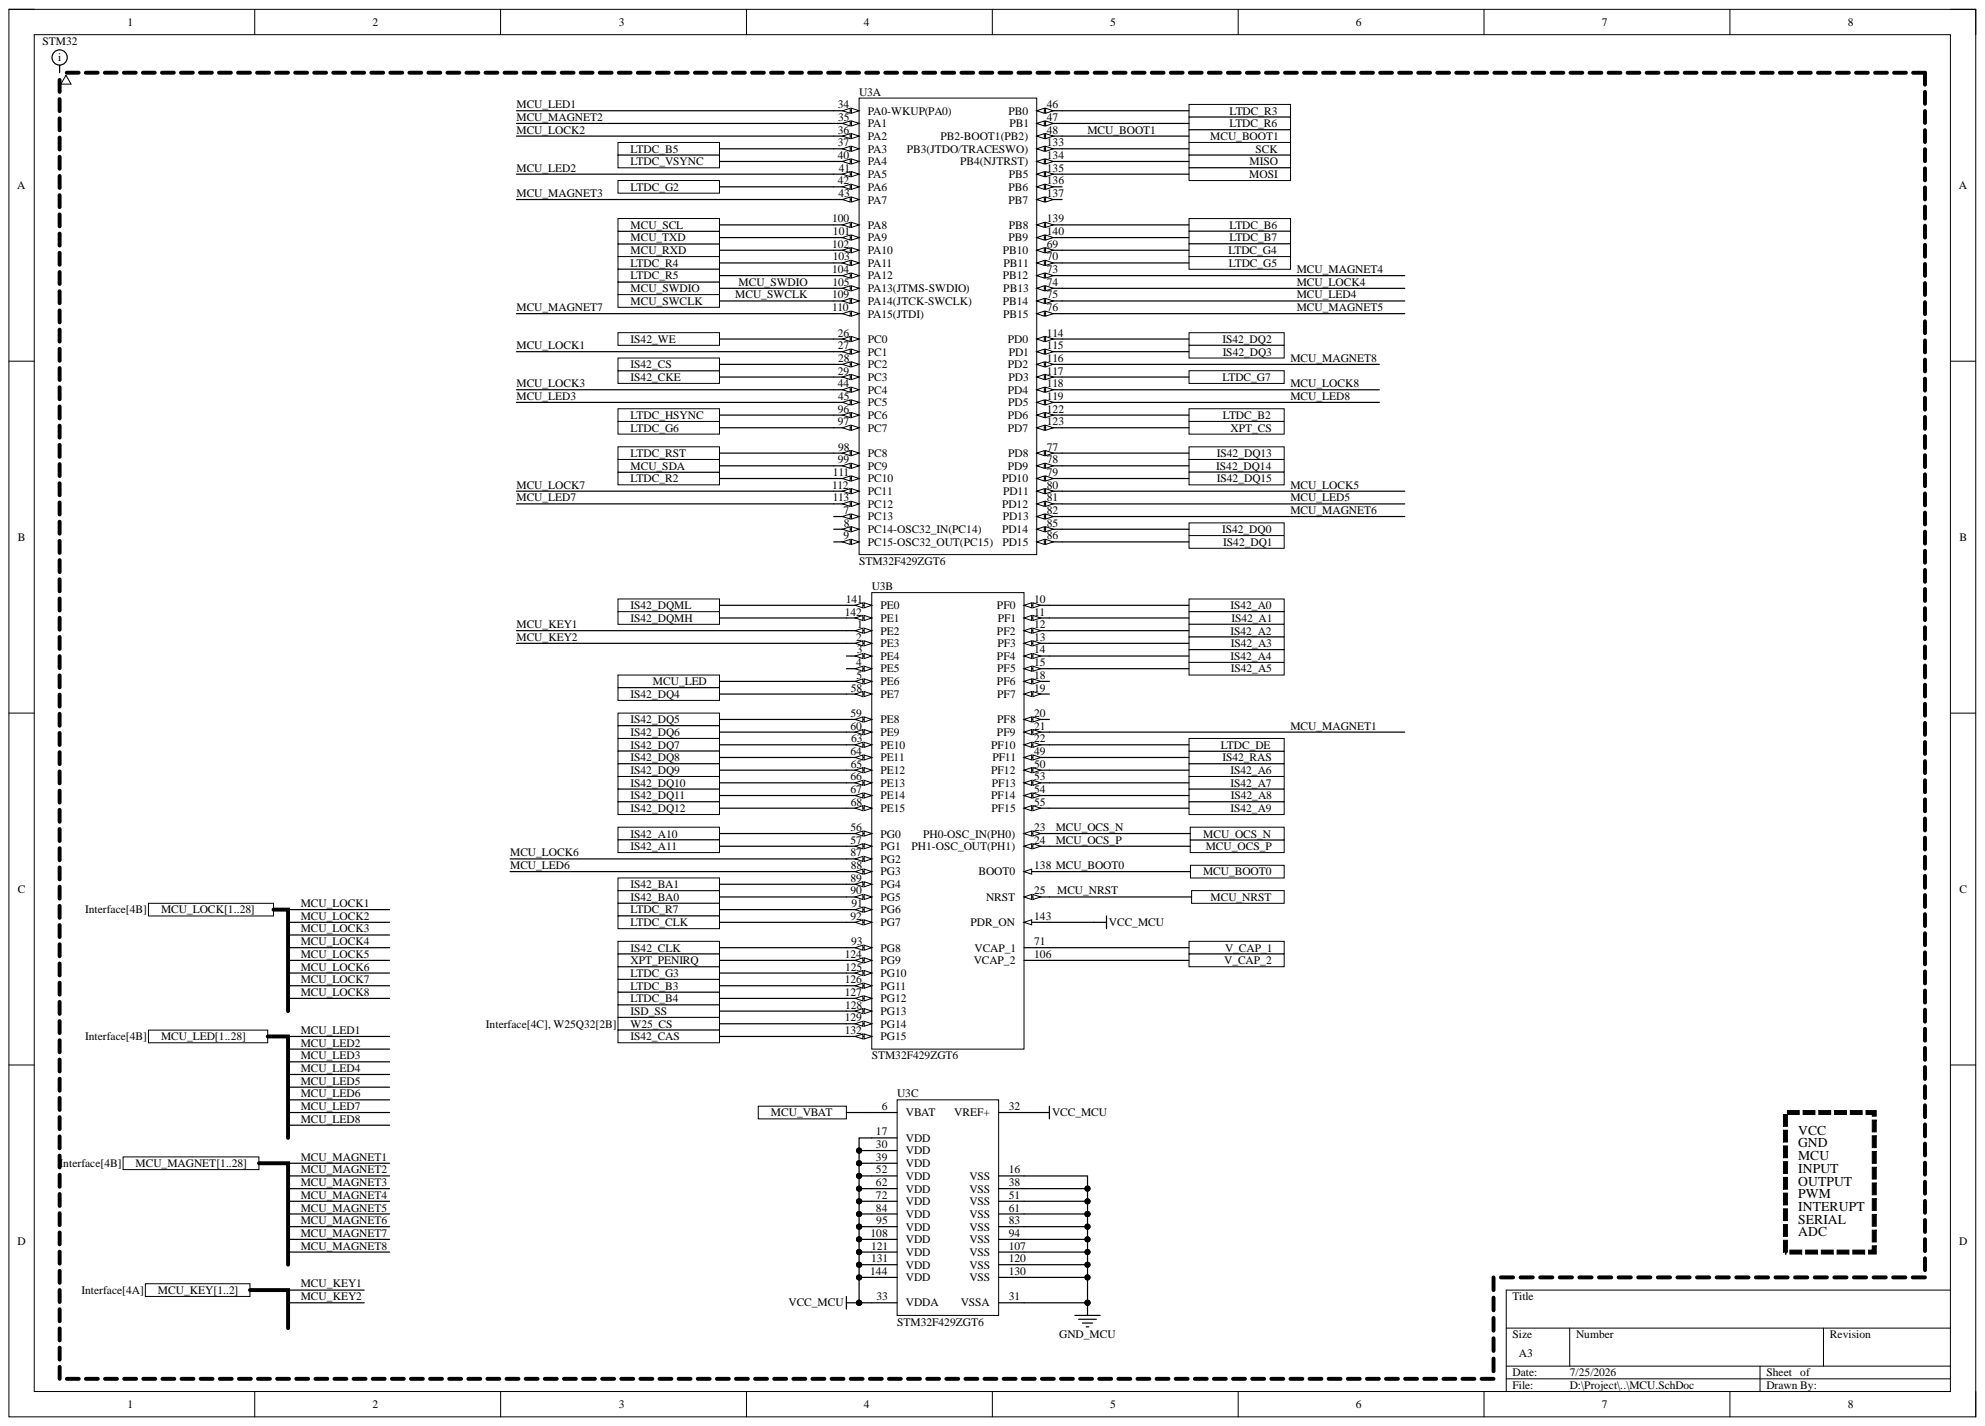
[picture p15: page 15]

MCU_SWCLK | PC0 26

PC4 44 PC5 45 PC6 96 | 1 1 9 | LTDC_G 7

LTDC_HSY N C | PC7 97 | LTDC_B2
LTDC_G 6 | PC8 98 | XPT_CS

MCU_SD A | 1 1 1 | IS42_D Q14

IS42_D QMH | 1 1 | IS42_A 1

XPT_PEN IRQ | PG10 125

ISD_SS | PG14 129

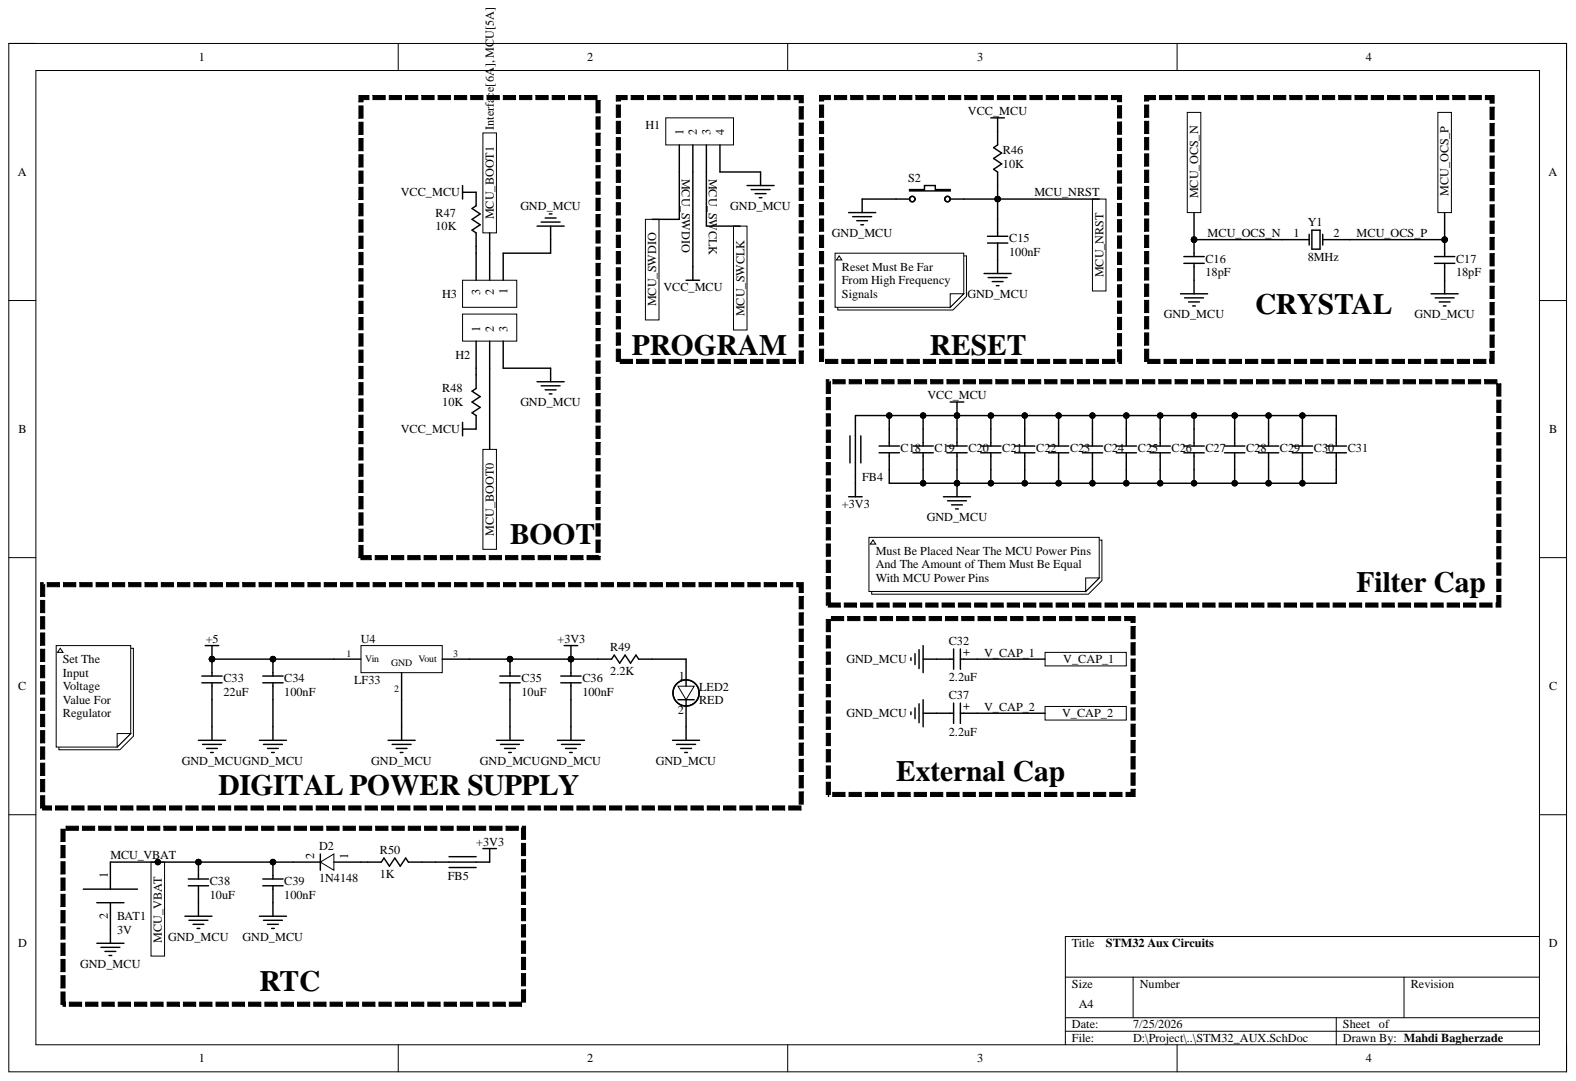
[picture p16: page 16]

Reset Must Be Far
From High Frequency
Signals

Must Be Placed Near The MCU Power Pins
And The Amount of Them Must Be Equal
With MCU Power Pins

Size A4 | Number | Revision

Date: 7/25/2026 | Sheet of
File: D:\Project\..\STM32_AUX.SchDoc | Drawn By: Mahdi Bagherzade

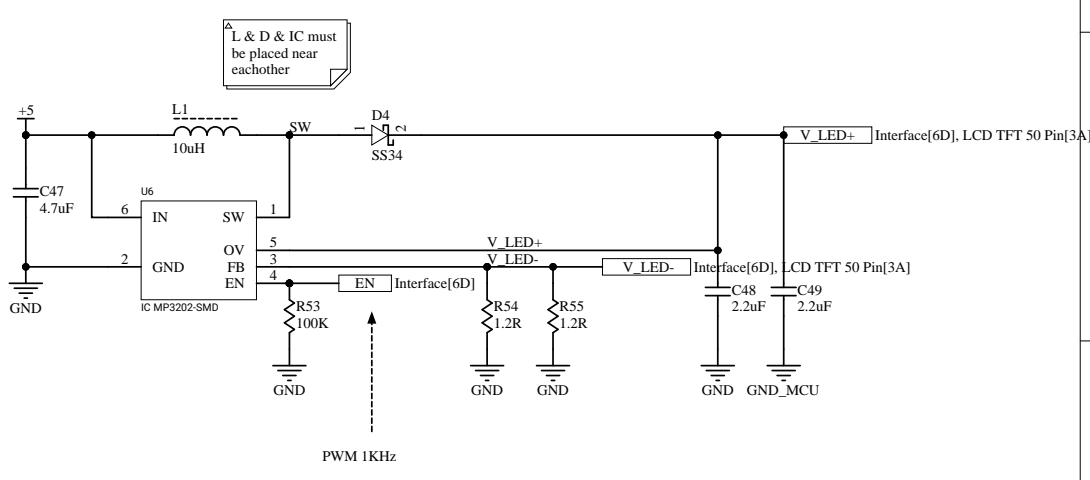
[picture p17: page 17]

V_LED+

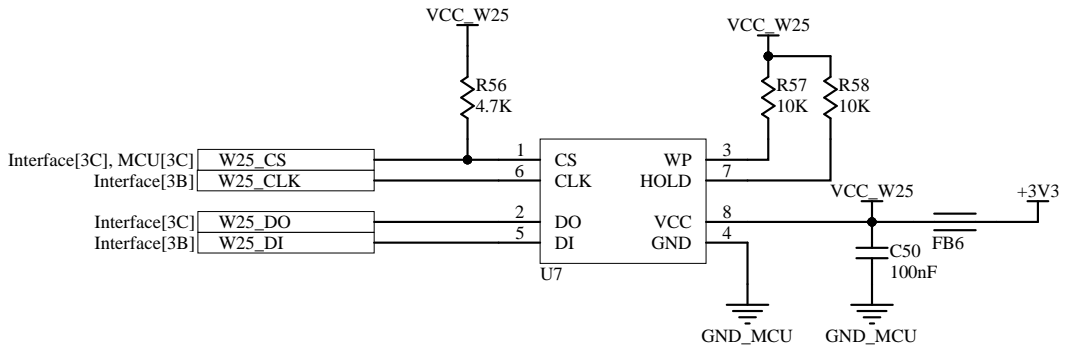
[picture p18: page 18]

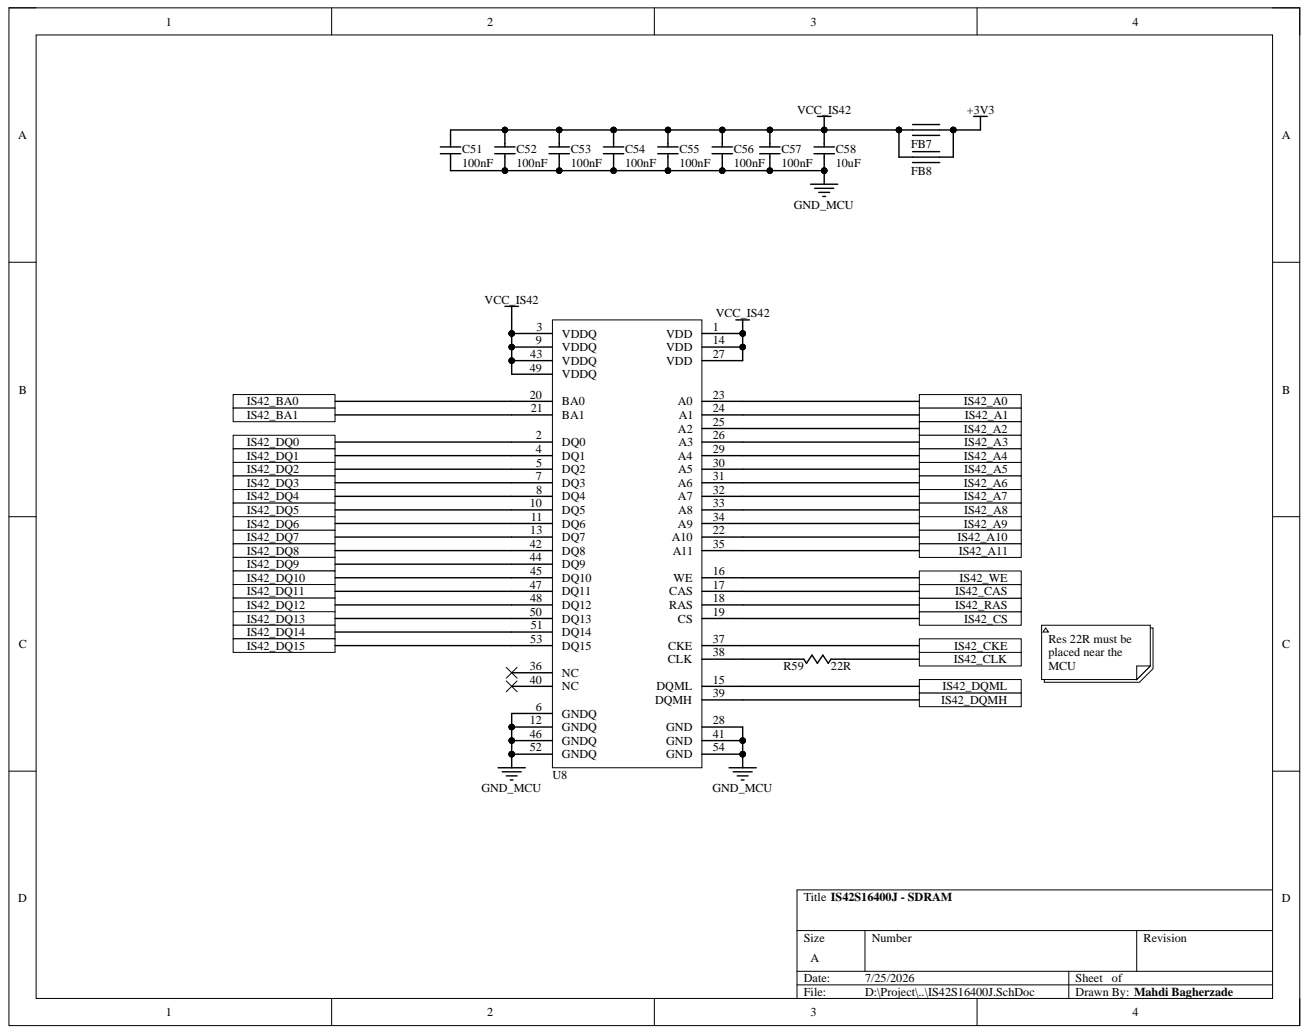
[picture p19: page 19]

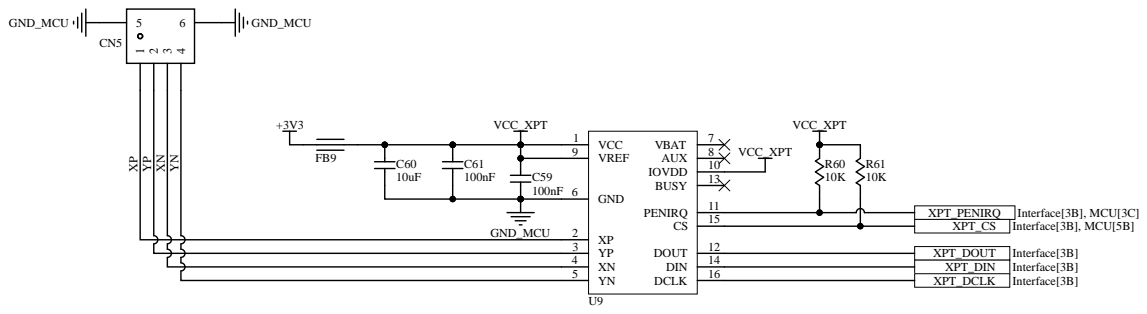
[picture p20: page 20]

+3V3 VCC_XPT

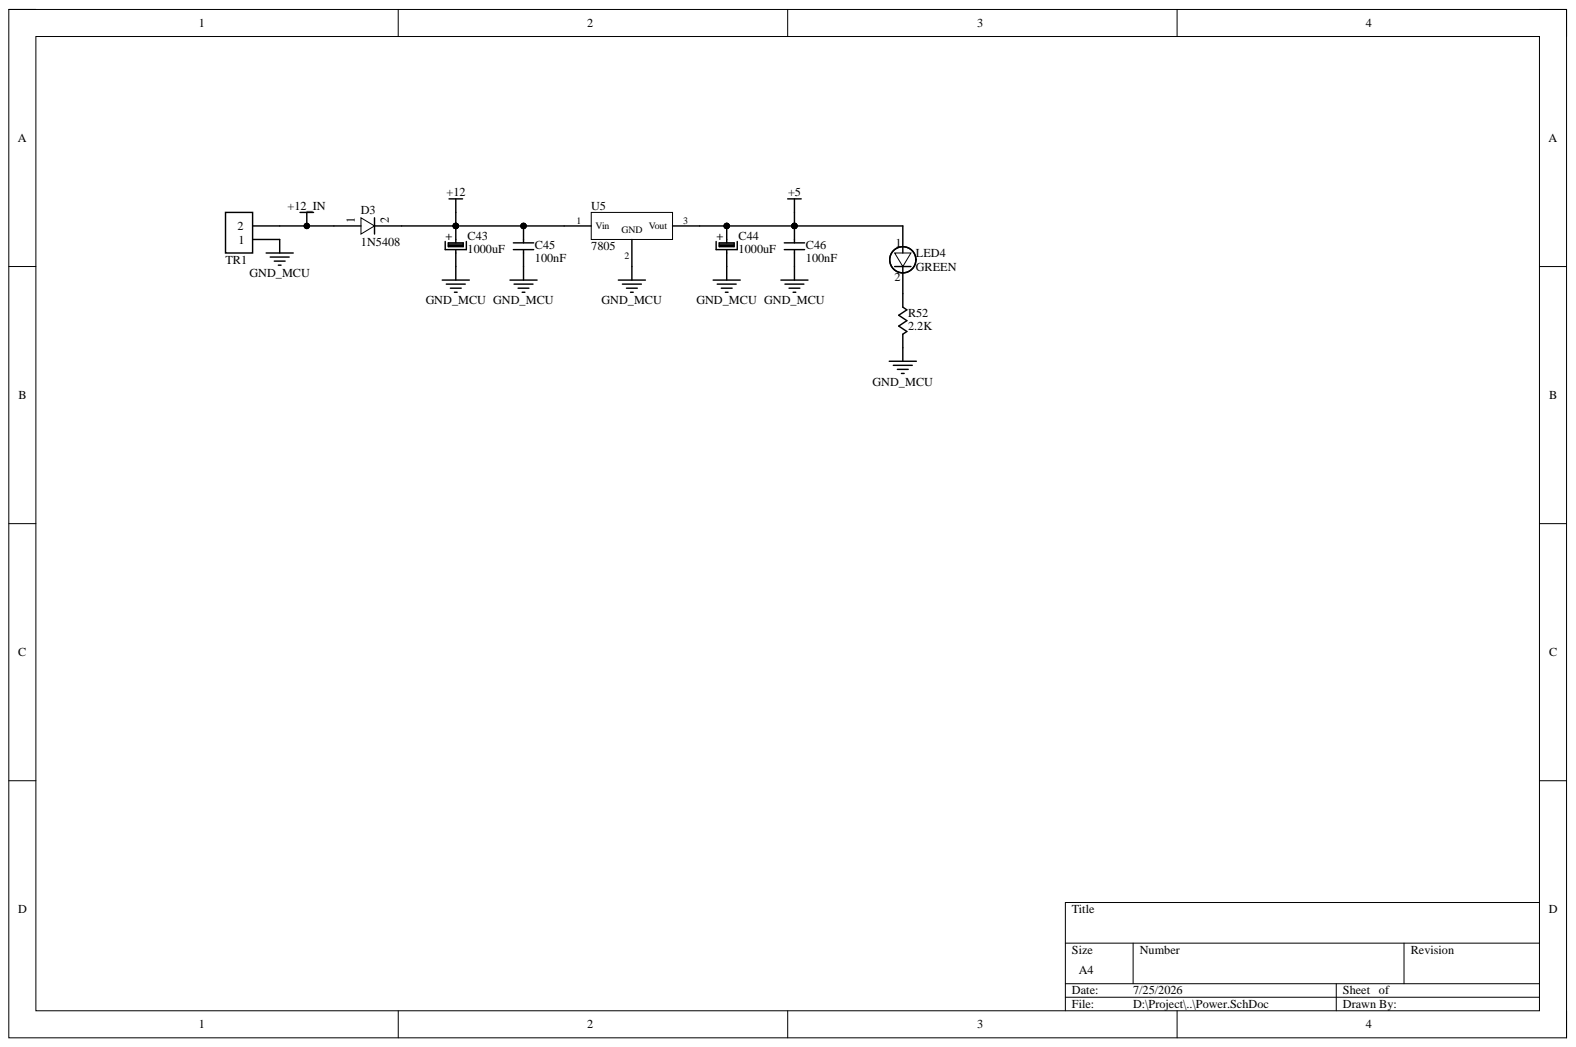
[picture p21: page 21]

Size A 4 | Numbe r | Revision

Date: 7/25/2026 | Sheet of
File: D:\Project\..\Power.SchDoc | Drawn By:

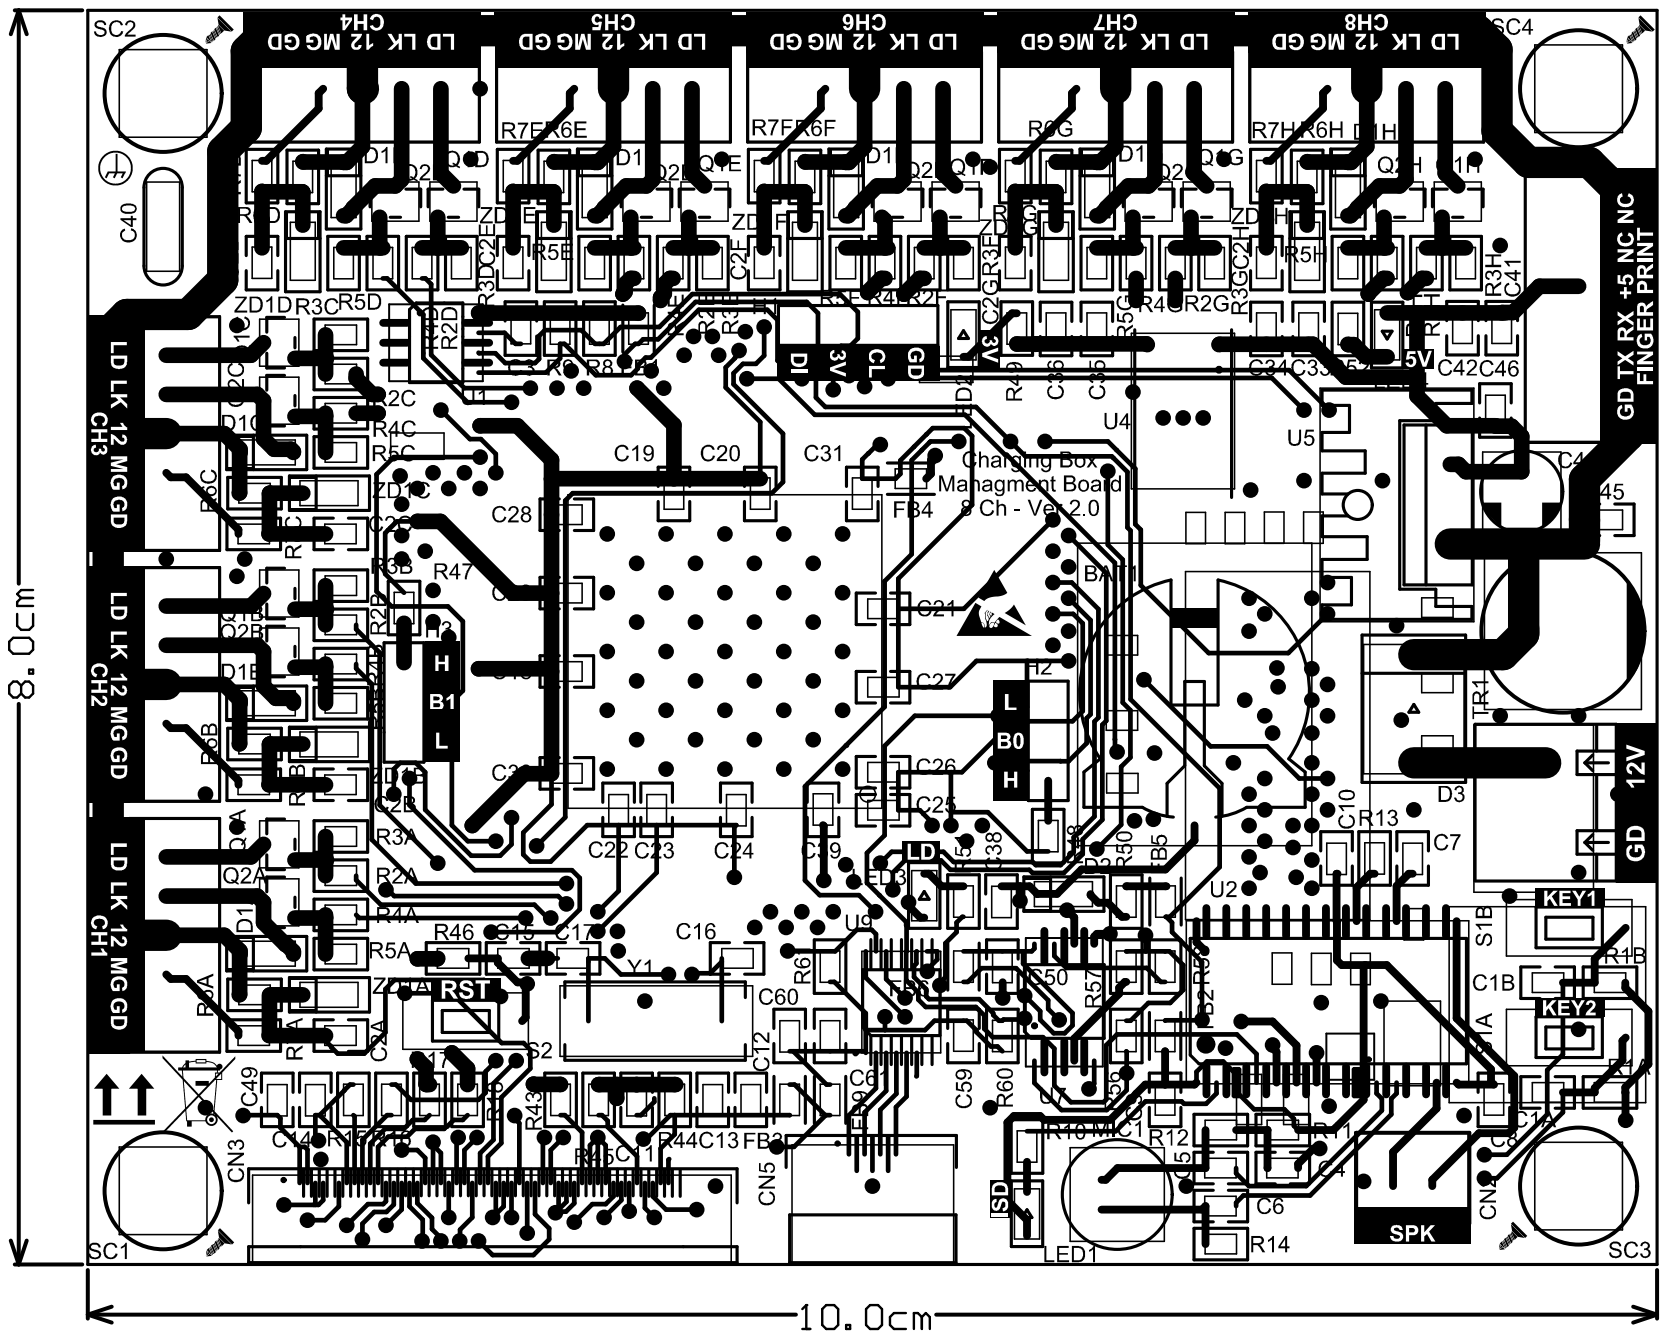
[picture p22: page 22]
