eng4313/Power-Box/(list of files, drawings)

Other design files:
PCB/Power_Box_V0/Channel - EX.SchDoc
PCB/Power_Box_V0/Channel.SchDoc
PCB/Power_Box_V0/Digital Input.SchDoc
PCB/Power_Box_V0/DS1307.SchDoc
PCB/Power_Box_V0/EEPROM.SchDoc
PCB/Power_Box_V0/Interface.SchDoc
PCB/Power_Box_V0/ISD1730.SchDoc
PCB/Power_Box_V0/LCD TFT 40 Pin.SchDoc
PCB/Power_Box_V0/MCU.SchDoc
PCB/Power_Box_V0/Power.SchDoc
PCB/Power_Box_V0/Power_Box_V0.PcbDoc
PCB/Power_Box_V0/Power_Box_V0.PrjPcb
PCB/Power_Box_V0/STM32_AUX.SchDoc
PCB/Power_Box_V0/ULN2003.SchDoc
PCB/Power_Box_V1/Channel.SchDoc
PCB/Power_Box_V1/Digital Input.SchDoc
PCB/Power_Box_V1/DS1307.SchDoc
PCB/Power_Box_V1/EEPROM.SchDoc
PCB/Power_Box_V1/Interface.SchDoc
PCB/Power_Box_V1/ISD1730.SchDoc
PCB/Power_Box_V1/LCD TFT 40 Pin.SchDoc
PCB/Power_Box_V1/MCU.SchDoc
PCB/Power_Box_V1/Power.SchDoc
PCB/Power_Box_V1/Power_Box_V1.PcbDoc
PCB/Power_Box_V1/Power_Box_V1.PrjPcb
PCB/Power_Box_V1/STM32_AUX.SchDoc
PCB/Power_Box_V2/Channel.SchDoc
PCB/Power_Box_V2/Digital Input.SchDoc
PCB/Power_Box_V2/DS1307.SchDoc
PCB/Power_Box_V2/EEPROM.SchDoc
PCB/Power_Box_V2/Interface.SchDoc
PCB/Power_Box_V2/IS42S16400J.SchDoc
PCB/Power_Box_V2/ISD1730.SchDoc
PCB/Power_Box_V2/LCD TFT 50 Pin.SchDoc
PCB/Power_Box_V2/MC3202.SchDoc
PCB/Power_Box_V2/MCU.SchDoc
PCB/Power_Box_V2/Power.SchDoc
PCB/Power_Box_V2/Power_Box_V2.PcbDoc
PCB/Power_Box_V2/Power_Box_V2.PrjPcb
PCB/Power_Box_V2/STM32_AUX.SchDoc
PCB/Power_Box_V2/Touch XPT2046.SchDoc
PCB/Power_Box_V2/W25Q32.SchDoc
