eng4313/Power-Box/Code/Power_Box_V2/Core/Src/main.c

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
/* Includes ------------------------------------------------------------------*/
#include "main.h"

/* USER CODE BEGIN Includes */
#include "w25q32.h"
#include "spi_bus.h"
#include "lcd.h"
#include "backlight.h"
#include "sdram.h"
#include "touch.h"
#include "isd1730.h"
#include "zfm40.h"
#include "AT24Cxx.h"
#include "rtc.h"
#include "debug_link.h"
#include "ui_interface.h"
#include "channel_hw.h"
#include "channel_manager.h"
#include "storage.h"
#include "log.h"
#include "flow_manager.h"
/* USER CODE END Includes */

/* USER CODE BEGIN PD */
/* PA0 blinks once when a scanned finger matches a template already
   stored in the module; not currently driven by application code, but
   left configured (safe, off) as an available feedback hook. */
#define FP_MATCH_LED_GPIO_Port     GPIOA
#define FP_MATCH_LED_Pin           GPIO_PIN_0
/* USER CODE END PD */

I2C_HandleTypeDef hi2c3;

LTDC_HandleTypeDef hltdc;

RTC_HandleTypeDef hrtc;

SPI_HandleTypeDef hspi1;

TIM_HandleTypeDef htim4;
TIM_HandleTypeDef htim14;

UART_HandleTypeDef huart7;
UART_HandleTypeDef huart1;
DMA_HandleTypeDef hdma_uart7_rx;

SDRAM_HandleTypeDef hsdram1;

void SystemClock_Config(void);
static void MX_GPIO_Init(void);
static void MX_DMA_Init(void);
static void MX_LTDC_Init(void);
static void MX_FMC_Init(void);
static void MX_I2C3_Init(void);
static void MX_SPI1_Init(void);
static void MX_USART1_UART_Init(void);
static void MX_TIM4_Init(void);
static void MX_RTC_Init(void);
static void MX_TIM14_Init(void);
static void MX_UART7_Init(void);
/**
  * @brief  The application entry point.
  * @retval int
  */
int main(void)
{

  /* MCU Configuration--------------------------------------------------------*/

  /* Reset of all peripherals, Initializes the Flash interface and the Systick. */
  HAL_Init();

  /* Configure the system clock */
  SystemClock_Config();

  /* Initialize all configured peripherals */
  MX_GPIO_Init();
  MX_DMA_Init();
  MX_LTDC_Init();
  MX_FMC_Init();
  MX_I2C3_Init();
  MX_SPI1_Init();
  MX_USART1_UART_Init();
  MX_TIM4_Init();
  MX_RTC_Init();
  MX_TIM14_Init();
  MX_UART7_Init();
  /* USER CODE BEGIN 2 */

	
  HAL_TIM_Base_Start_IT(&htim14);
	


  /* DebugLink first: no peripheral dependency beyond MX_UART7_Init()
   * (already done above), and every later init-failure message below
   * needs it ready to actually reach the PC tool. */
  DebugLink_Init(&huart7);
  DebugLink_RegisterCallback(UI_ProcessIncomingLine);
  UI_Init();

  /* ---- Boot sequence: order matters, see each module's header for its
   * documented dependency on the ones before it. ---- */
  Backlight_Init();
  Backlight_SetBrightness(50);

  RTC_Init();

  SPI_Bus_Init();                 /* must precede ISD1730_Init() / W25Q32_Init() */
  if (ISD1730_Init() != ISD_OK)
  {
      DebugLink_SendLine("OUT:LOG:ISD1730_Init failed");
  }
  if (W25Q32_Init() != W25_OK)
  {
      DebugLink_SendLine("OUT:LOG:W25Q32_Init failed");
  }

  if (ZFM40_Init() != ZFM_OK)
  {
      DebugLink_SendLine("OUT:LOG:ZFM40_Init failed");
  }
  HAL_Delay(500); /* module boot time before the first command */
  {
      uint8_t confirm;
      if ((ZFM40_VerifyPassword(0x00000000, &confirm) != ZFM_OK) || (confirm != ZFM_CONF_OK))
      {
          DebugLink_SendLine("OUT:LOG:ZFM40 password verify failed");
      }
  }

  if (ChannelHW_Init() != SYS_OK)     /* before Storage_Init()/ChannelManager_Init() */
  {
      DebugLink_SendLine("OUT:LOG:ChannelHW_Init failed");
  }
  if (Storage_Init() != SYS_OK)       /* before Log_Init()/ChannelManager_Init() */
  {
      DebugLink_SendLine("OUT:LOG:Storage_Init failed");
  }
  if (Log_Init() != SYS_OK)           /* needs Storage_Init() + W25Q32_Init() */
  {
      DebugLink_SendLine("OUT:LOG:Log_Init failed");
  }
  if (ChannelManager_Init() != SYS_OK) /* needs Storage_Init() + ChannelHW_Init() */
  {
      DebugLink_SendLine("OUT:LOG:ChannelManager_Init failed");
  }

  FlowManager_Init();
  /* USER CODE END 2 */

  /* Infinite loop */
  /* USER CODE BEGIN WHILE */
  while (1)
  {
    /* USER CODE END WHILE */

    /* USER CODE BEGIN 3 */
    DebugLink_Process();
    UI_Tick();
    FlowManager_Process();
  }
  /* USER CODE END 3 */
}

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
/* USER CODE BEGIN 4 */

void HAL_TIM_PeriodElapsedCallback(TIM_HandleTypeDef *htim)
{
    if (htim->Instance == TIM14)
    {
        HAL_GPIO_TogglePin(LD_GPIO_Port, LD_Pin); /* heartbeat indicator */
    }
}

void HAL_UARTEx_RxEventCallback(UART_HandleTypeDef *huart, uint16_t Size)
{
    DebugLink_RxEventCallback(huart, Size);
}
/* USER CODE END 4 */
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
