eng4313/Power-Box/(notices)

Notices in the files:
Code/Power_Box_V2/Core/Inc/main.h:
Copyright (c) 2026 STMicroelectronics.
All rights reserved.
This software is licensed under terms that can be found in the LICENSE file
